PiStOn-DeEp/1st-Philippine-Can-Satellite-Rocket-Competition-2024-2025/README.md

# 1st-Philippine-Can-Satellite-Rocket-Competition-2024-2025
Contains information and files of critical design review paper of our CanSat
