PiStOn-DeEp/1st-Philippine-Can-Satellite-Rocket-Competition-2024-2025/Assembly-Half-Payload-v1-1-1.pdf

E E

F F

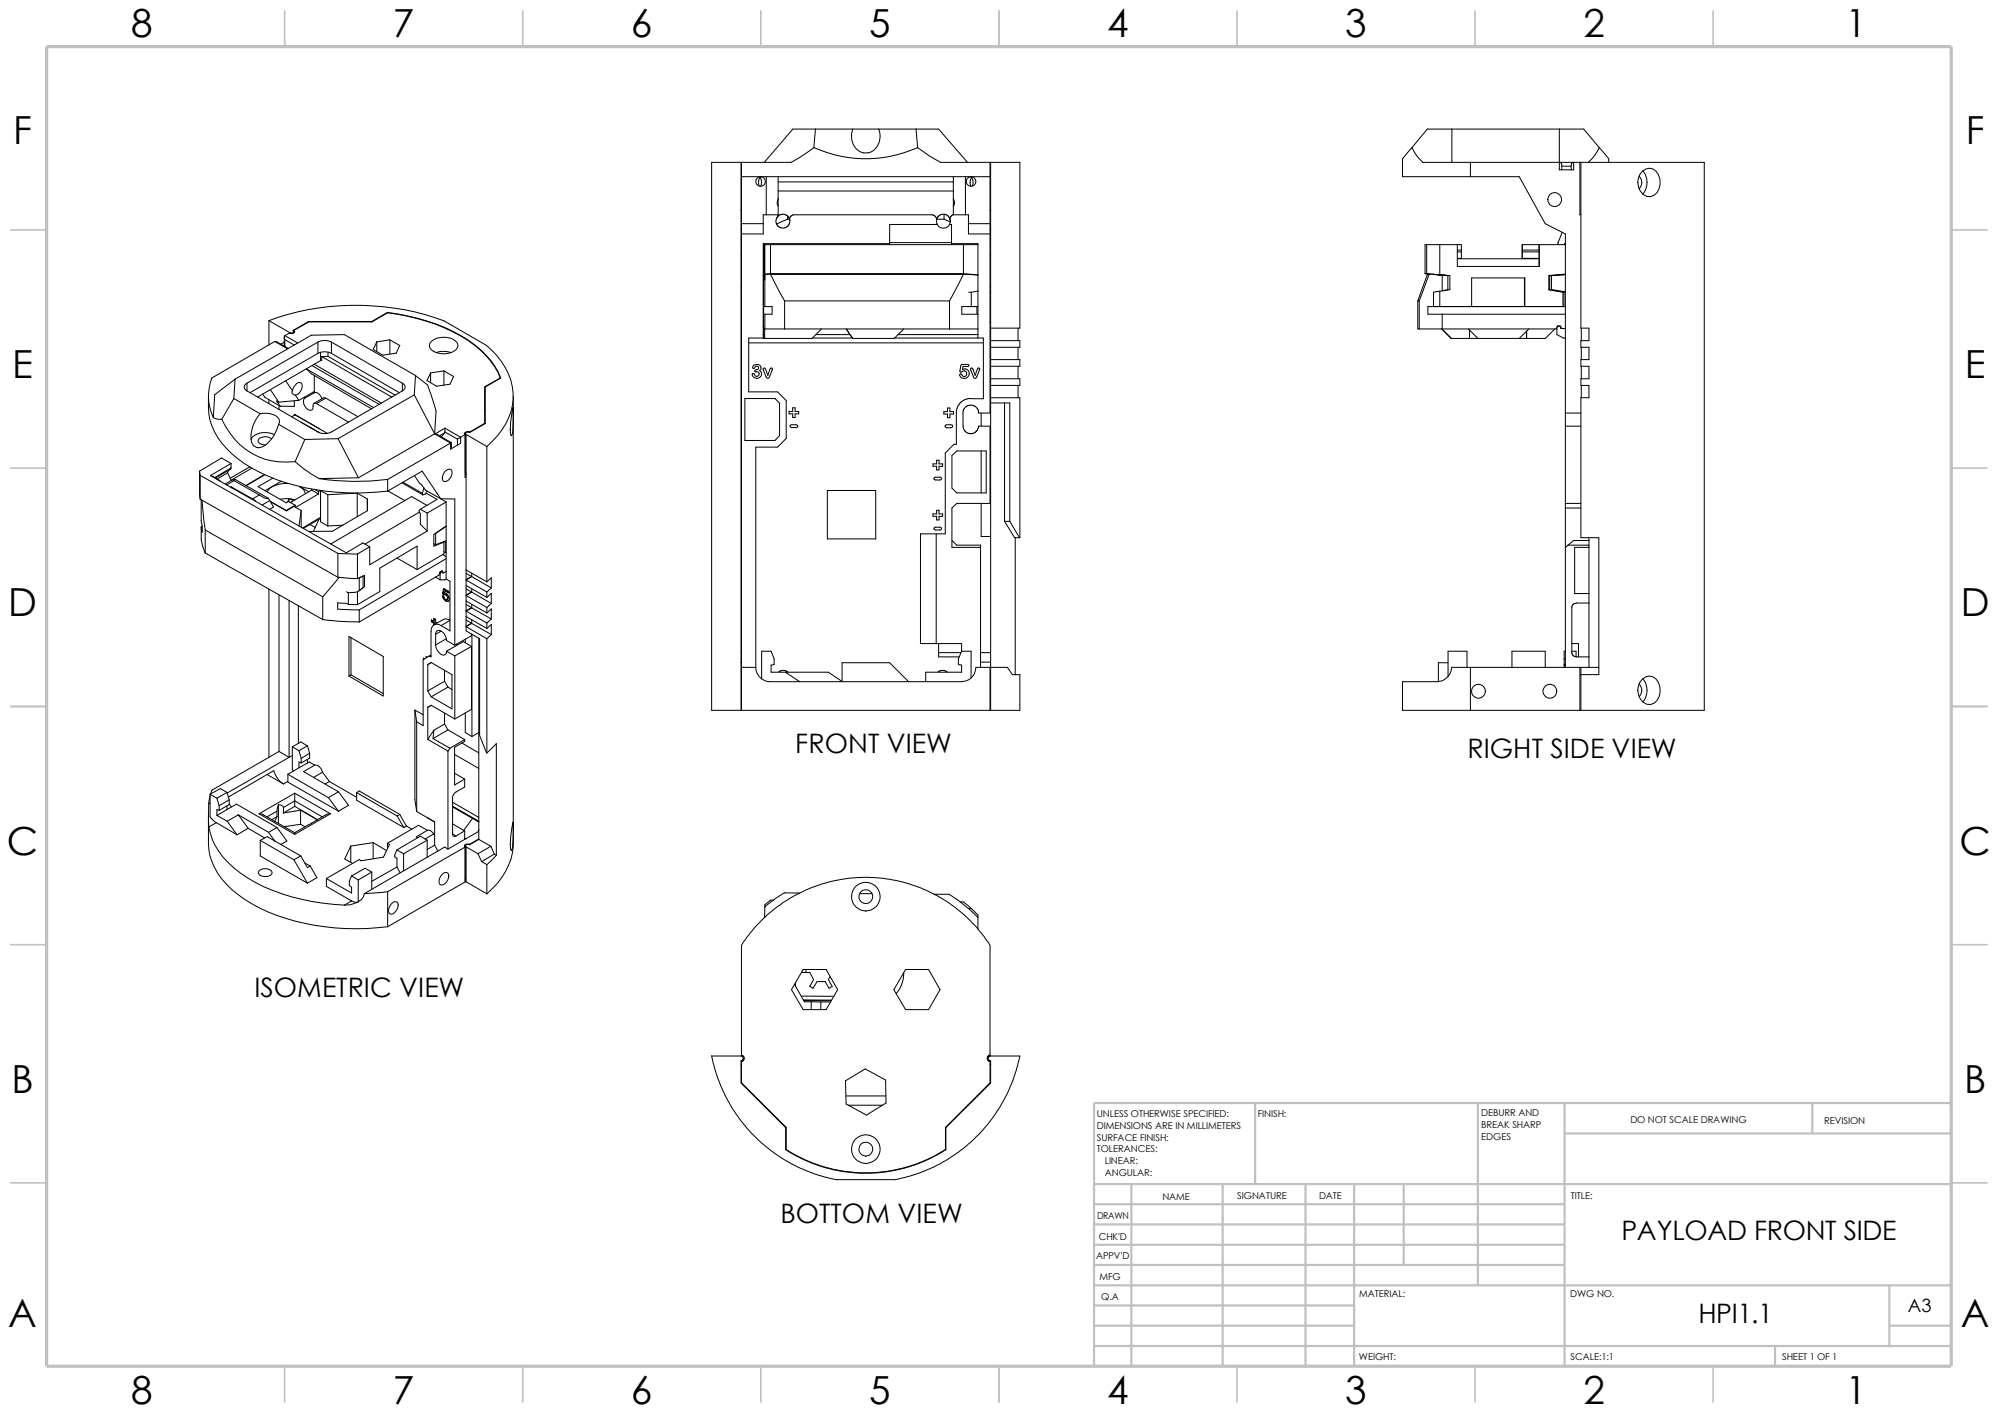
[picture p46: page 1]
SCALE:1:1; A A HPI1.1; WEIGHT:; SHEET 1 OF 1; REVISION; FINISH:; EDGES; DEBURR AND BREAK SHARP; ISOMETRIC VIEW; FRONT VIEW; BOTTOM VIEW

RIGHT SIDE VIEW

DO NOT SCALE DRAWING UNLESS OTHERWISE SPECIFIED:
DIMENSIONS ARE IN MILLIMETERS
SURFACE FINISH:
TOLERANCES:
LINEAR:
ANGULAR:

NAME | SIGNATURE | DATE | | | | TITLE: PAYLOAD FRONT SIDE

DRAWN
CHK'D
APPV'D
Q.A | | | | MATERIAL: | DWG NO. | A3

MFG
