PiStOn-DeEp/1st-Philippine-Can-Satellite-Rocket-Competition-2024-2025/Specimen-Payload-Case-v1-1.pdf

E E

F F

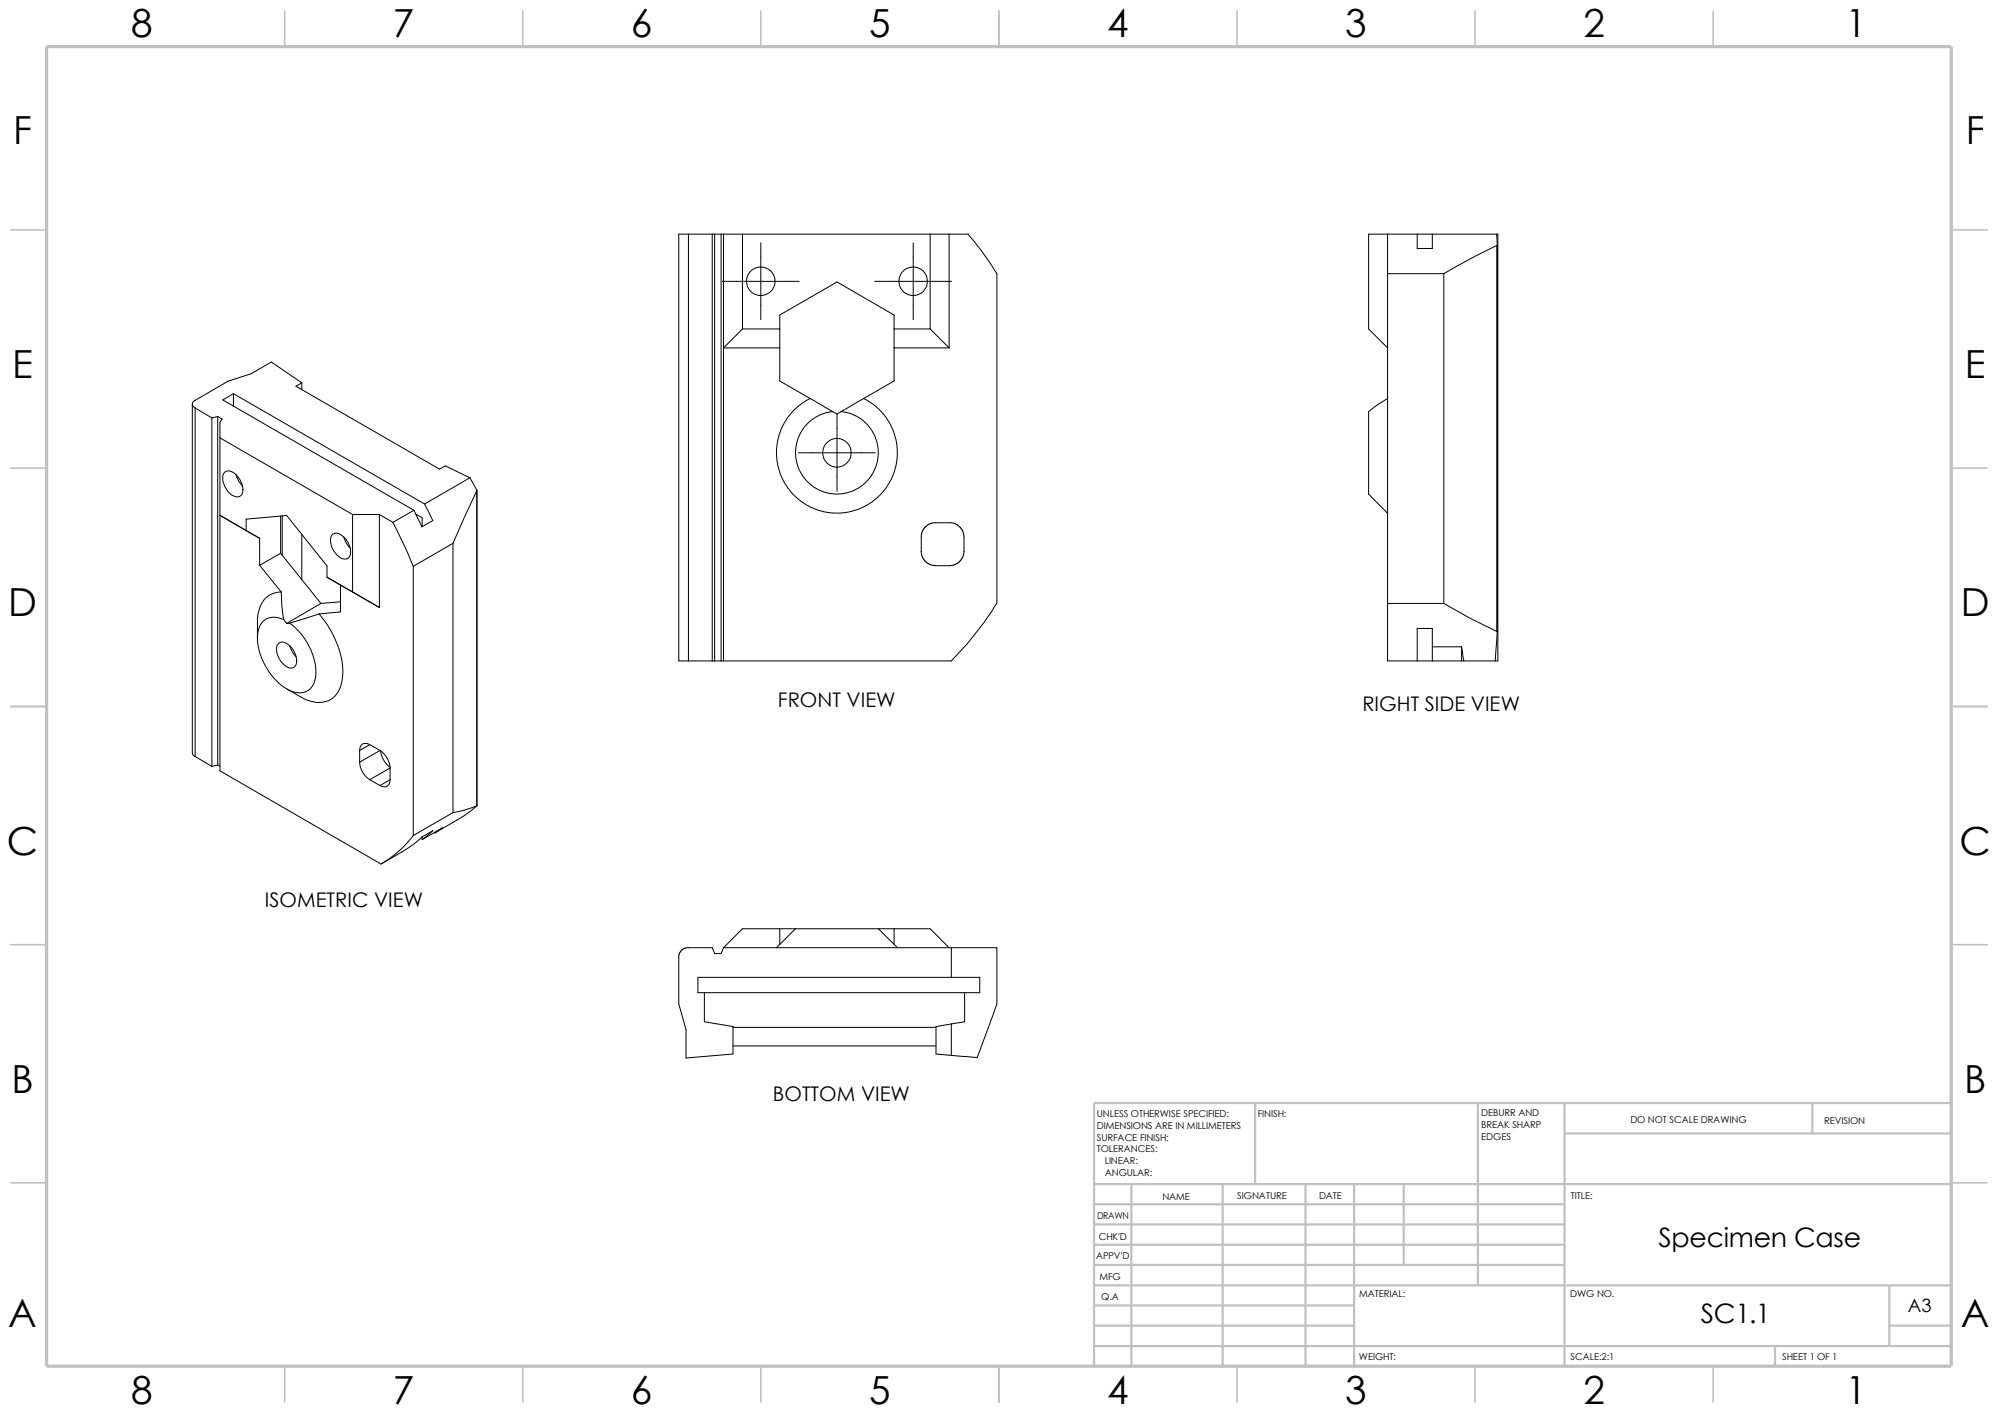
[picture p47: page 1]
SHEET 1 OF 1; WEIGHT:; REVISION; SCALE:2:1; FINISH:; EDGES; DEBURR AND BREAK SHARP; BOTTOM VIEW; ISOMETRIC VIEW; FRONT VIEW; RIGHT SIDE VIEW

UNLESS OTHERWISE SPECIFIED:
DIMENSIONS ARE IN MILLIMETERS
SURFACE FINISH:
TOLERANCES:
LINEAR:
ANGULAR:

DO NOT SCALE DRAWING

NAME | SIGNATURE | DATE | | | | TITLE: Specimen Case

DRAWN
CHK'D
APPV'D
Q.A | | | | MATERIAL: | DWG NO. | A3

MFG
