PiStOn-DeEp/1st-Philippine-Can-Satellite-Rocket-Competition-2024-2025/Specimen-Payload-Case-v1-2.pdf

E E

F F

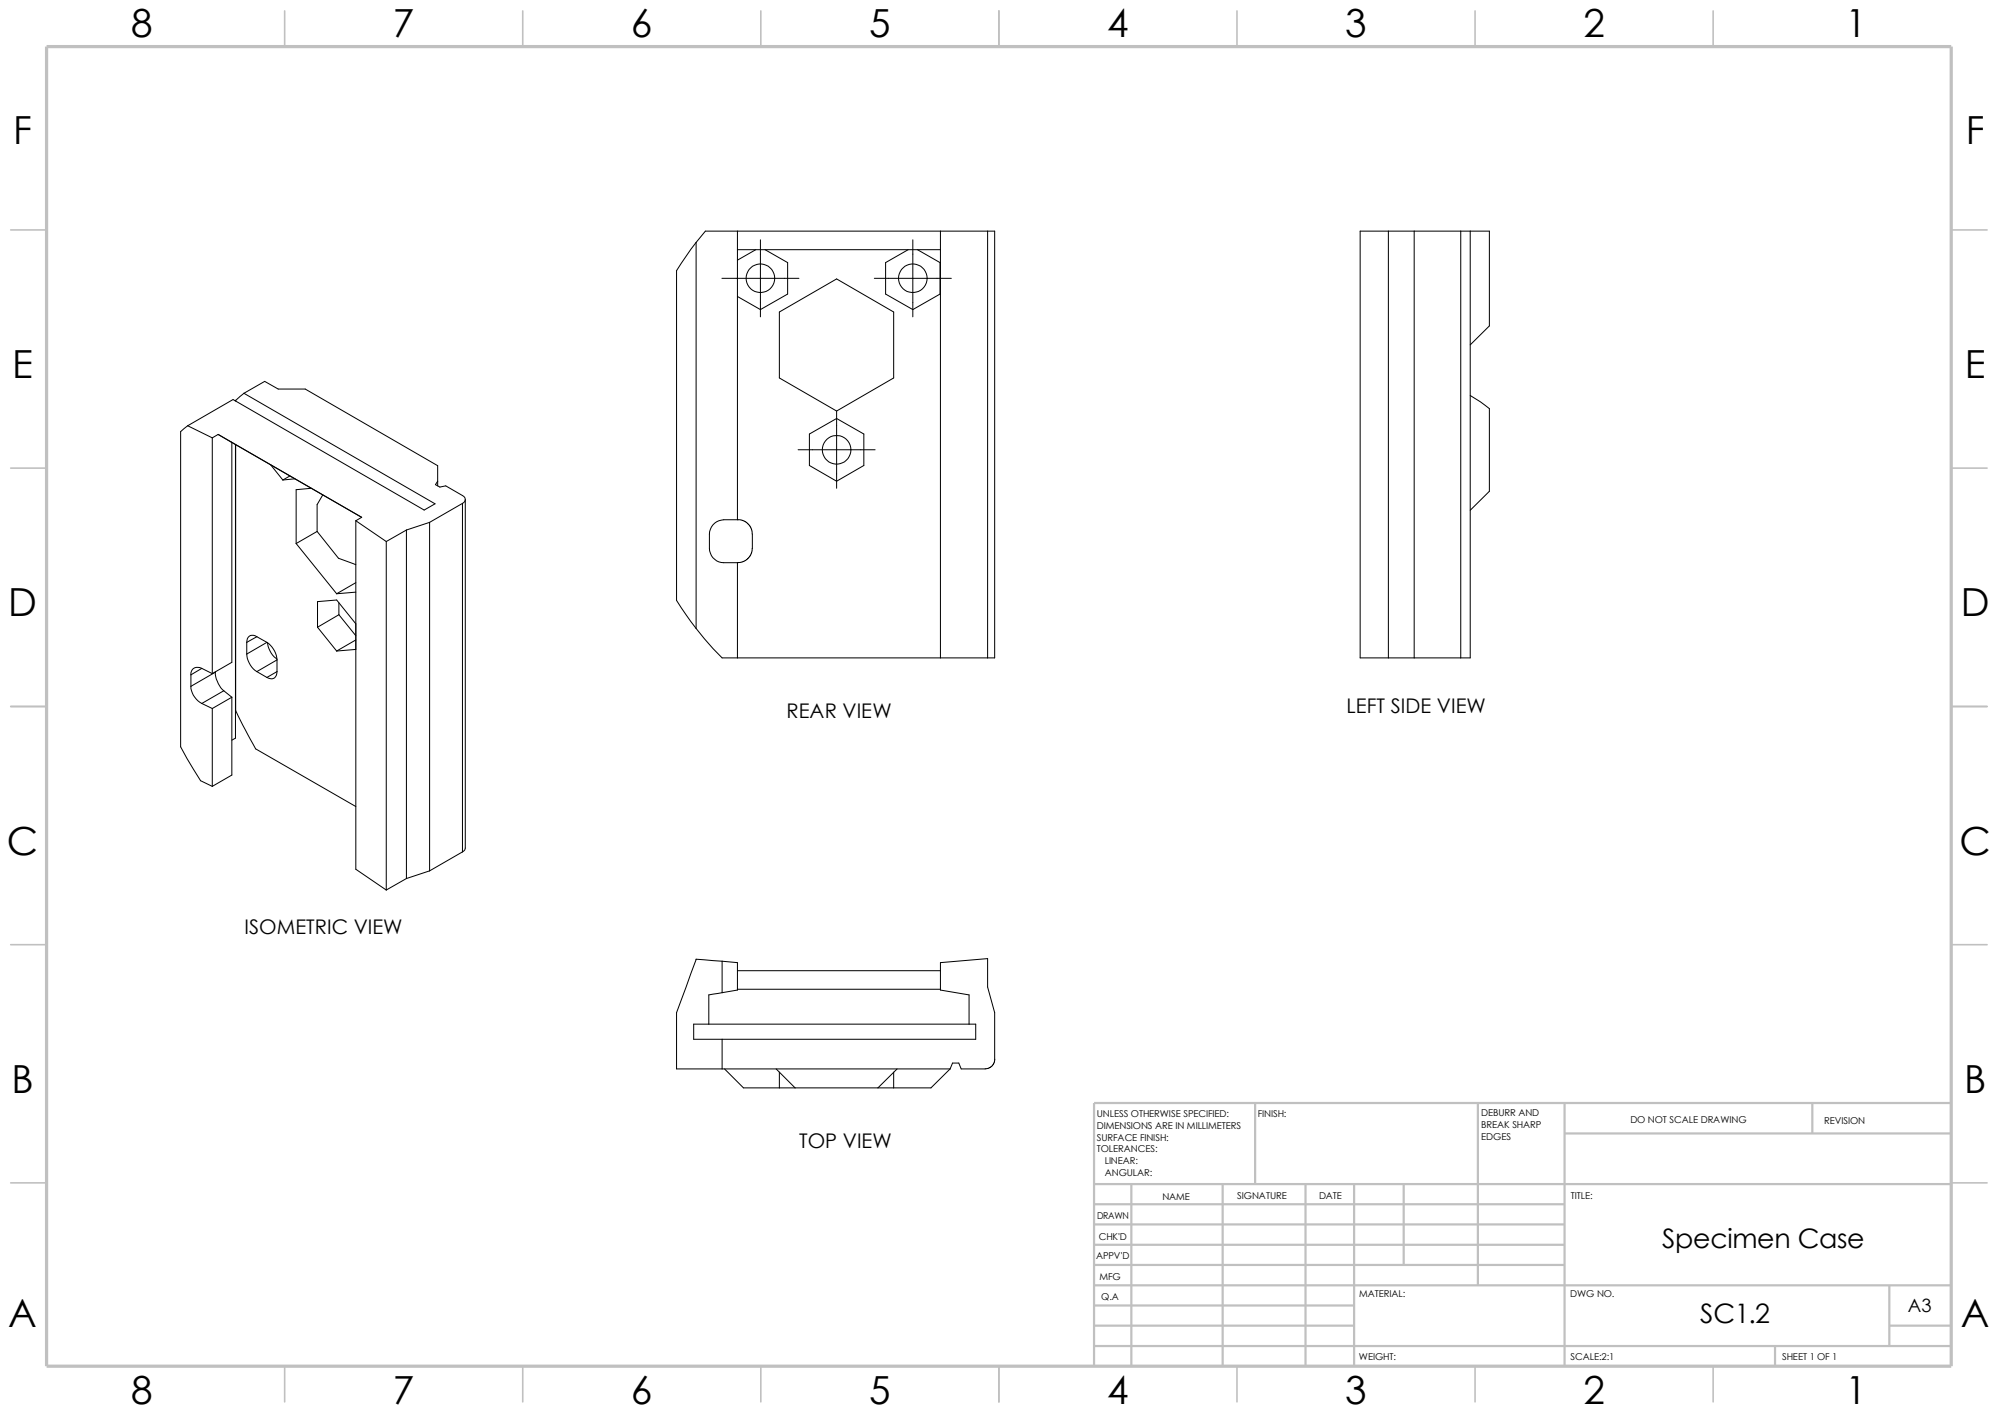
[picture p48: page 1]
SHEET 1 OF 1; WEIGHT:; SCALE:2:1; REVISION; FINISH:; EDGES; DEBURR AND BREAK SHARP; REAR VIEW; LEFT SIDE VIEW; ISOMETRIC VIEW; TOP VIEW

DO NOT SCALE DRAWING UNLESS OTHERWISE SPECIFIED:
DIMENSIONS ARE IN MILLIMETERS
SURFACE FINISH:
TOLERANCES:
LINEAR:
ANGULAR:

NAME | SIGNATURE | DATE | | | | TITLE: Specimen Case

DRAWN
CHK'D
APPV'D
Q.A | | | | MATERIAL: | DWG NO. | A3

MFG
