PiStOn-DeEp/1st-Philippine-Can-Satellite-Rocket-Competition-2024-2025/Whole-Assembly-v2-1-1.pdf

E E

F F

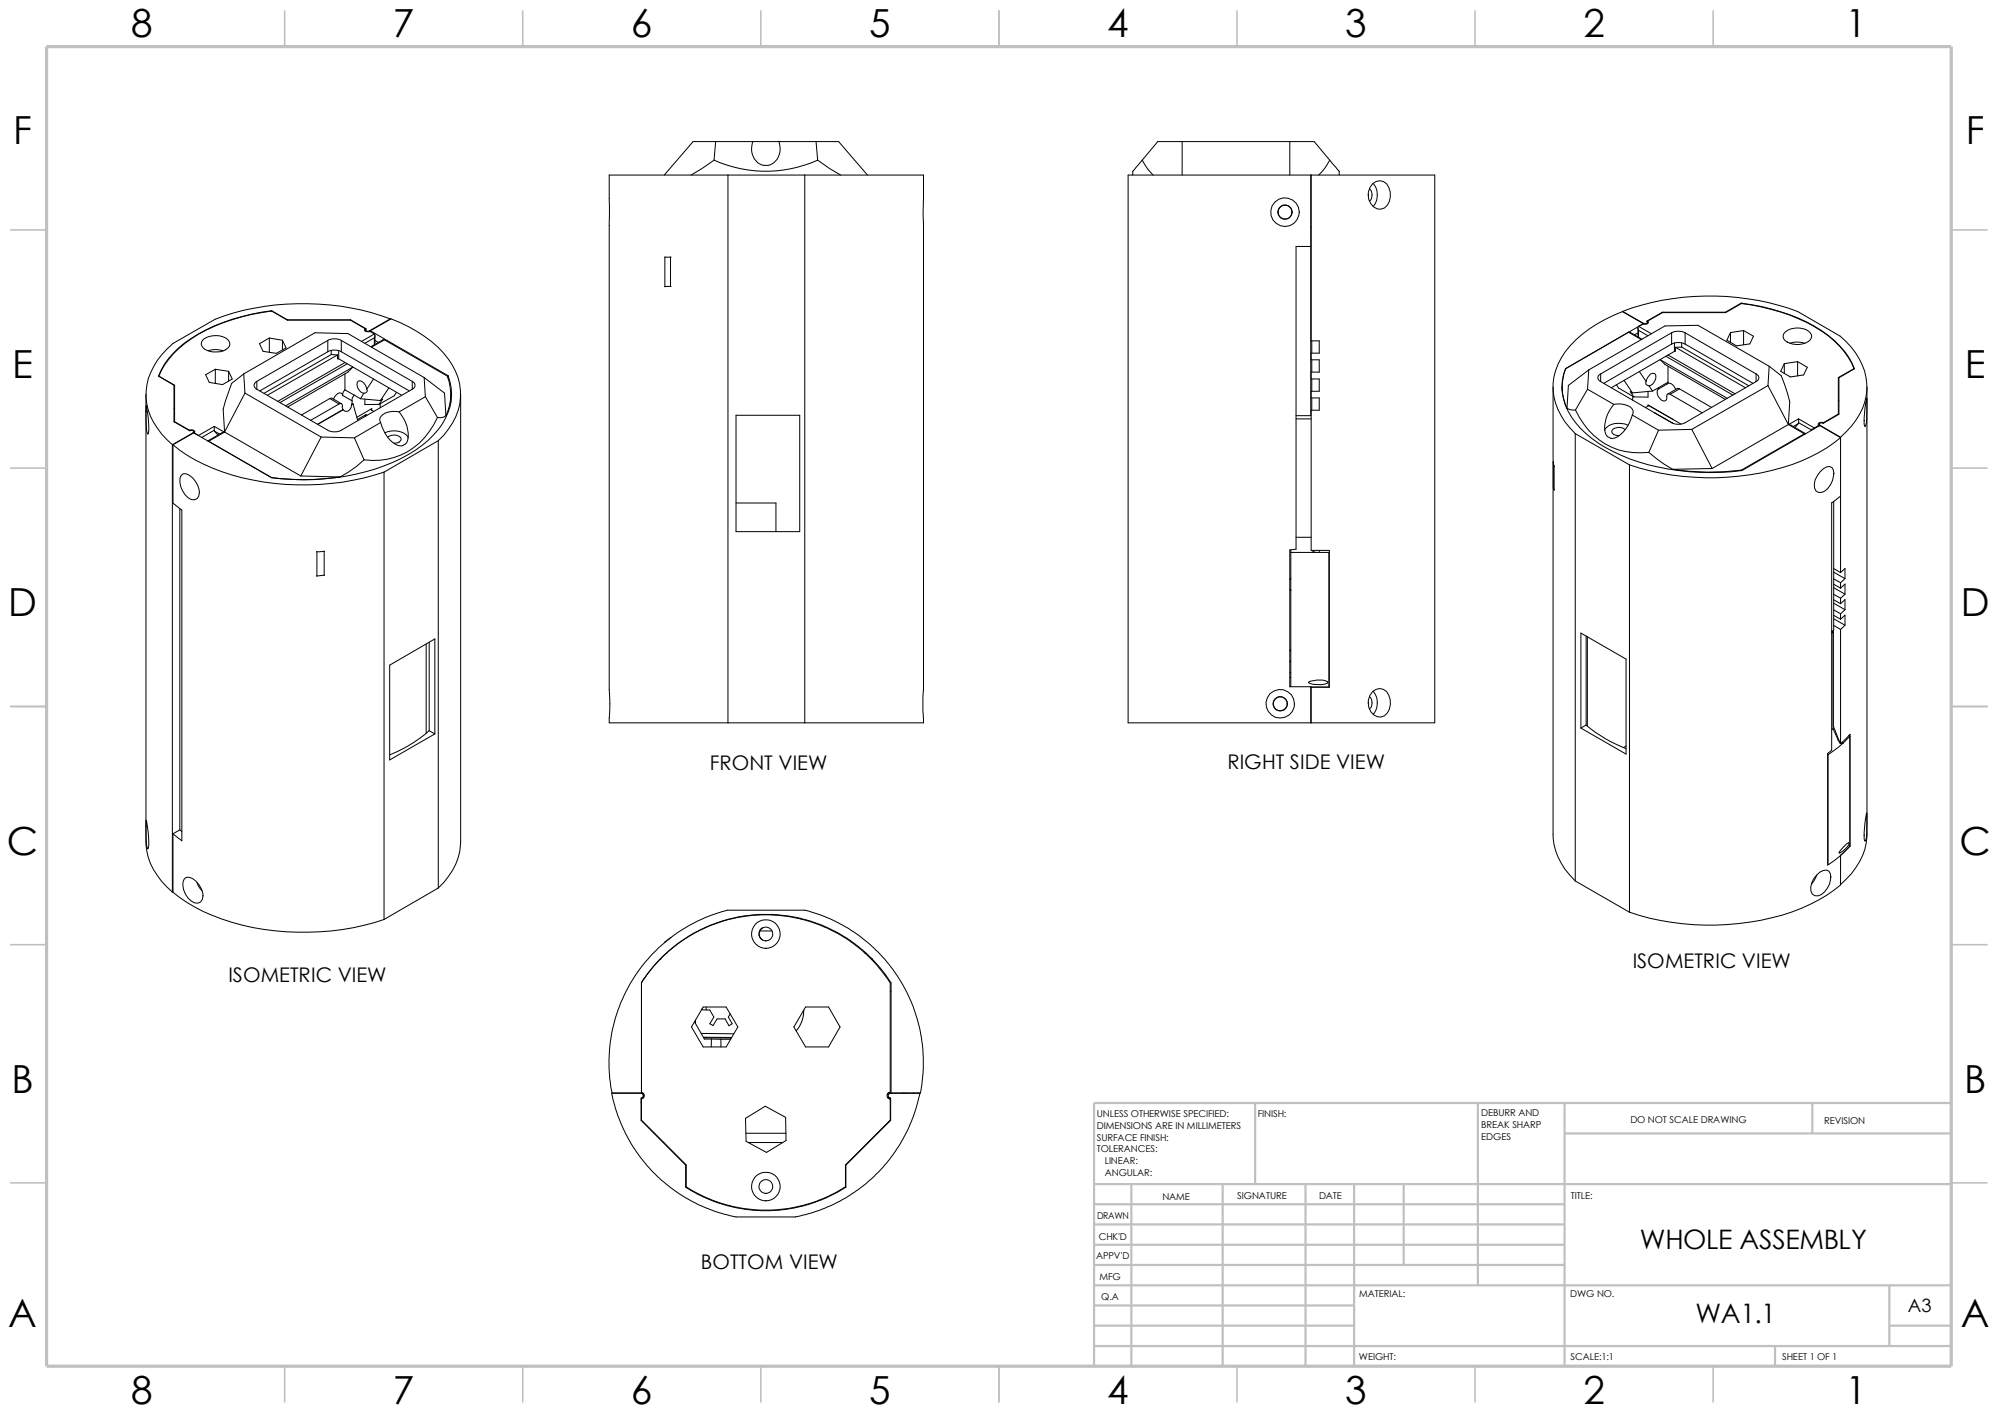
[picture p49: page 1]
WEIGHT:; SHEET 1 OF 1; SCALE:1:1; FINISH:; EDGES; DO NOT SCALE DRAWING; REVISION; DEBURR AND BREAK SHARP; BOTTOM VIEW; FRONT VIEW; RIGHT SIDE VIEW; ISOMETRIC VIEW

UNLESS OTHERWISE SPECIFIED:
DIMENSIONS ARE IN MILLIMETERS
SURFACE FINISH:
TOLERANCES:
LINEAR:
ANGULAR:

NAME | SIGNATURE | DATE | | | | TITLE: WHOLE ASSEMBLY

DRAWN
CHK'D
APPV'D

MFG
Q.A | | | | MATERIAL: | DWG NO. | A3
