PiStOn-DeEp/1st-Philippine-Can-Satellite-Rocket-Competition-2024-2025/Whole-Assembly-v2-1-2.pdf

E E

F F

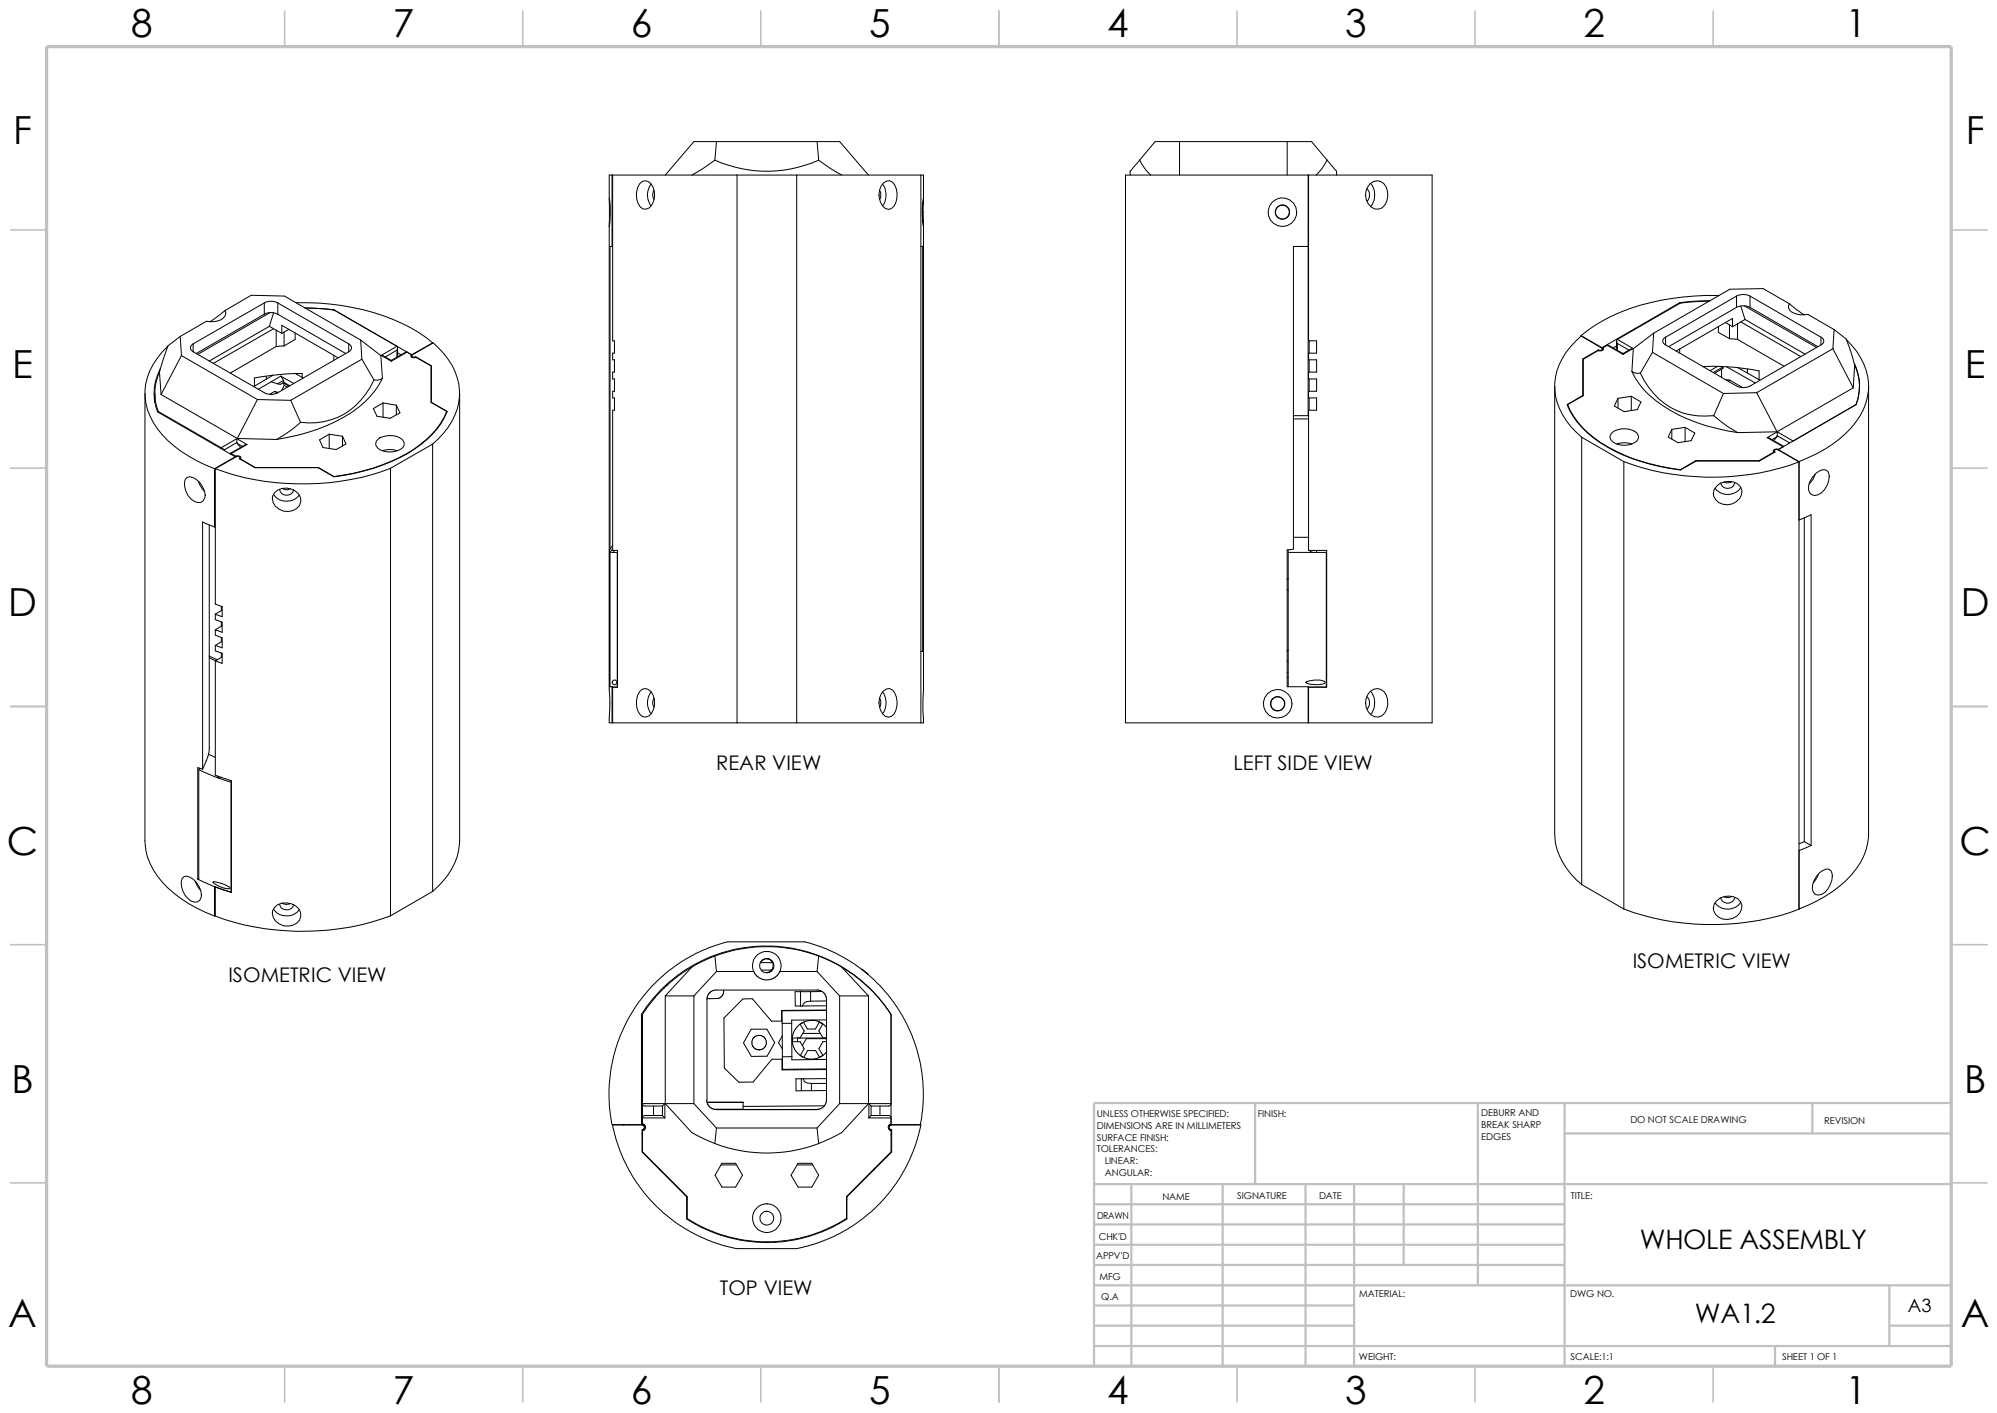
[picture p50: page 1]
WEIGHT:; SHEET 1 OF 1; SCALE:1:1; REVISION; FINISH:; EDGES; DEBURR AND BREAK SHARP; REAR VIEW; LEFT SIDE VIEW; TOP VIEW; ISOMETRIC VIEW

DO NOT SCALE DRAWING UNLESS OTHERWISE SPECIFIED:
DIMENSIONS ARE IN MILLIMETERS
SURFACE FINISH:
TOLERANCES:
LINEAR:
ANGULAR:

NAME | SIGNATURE | DATE | | | | TITLE: WHOLE ASSEMBLY

DRAWN
CHK'D
APPV'D
Q.A | | | | MATERIAL: | DWG NO. | A3

MFG
