PiStOn-DeEp/1st-Philippine-Can-Satellite-Rocket-Competition-2024-2025/Battery-Frame-v1-1.pdf

E E

F F

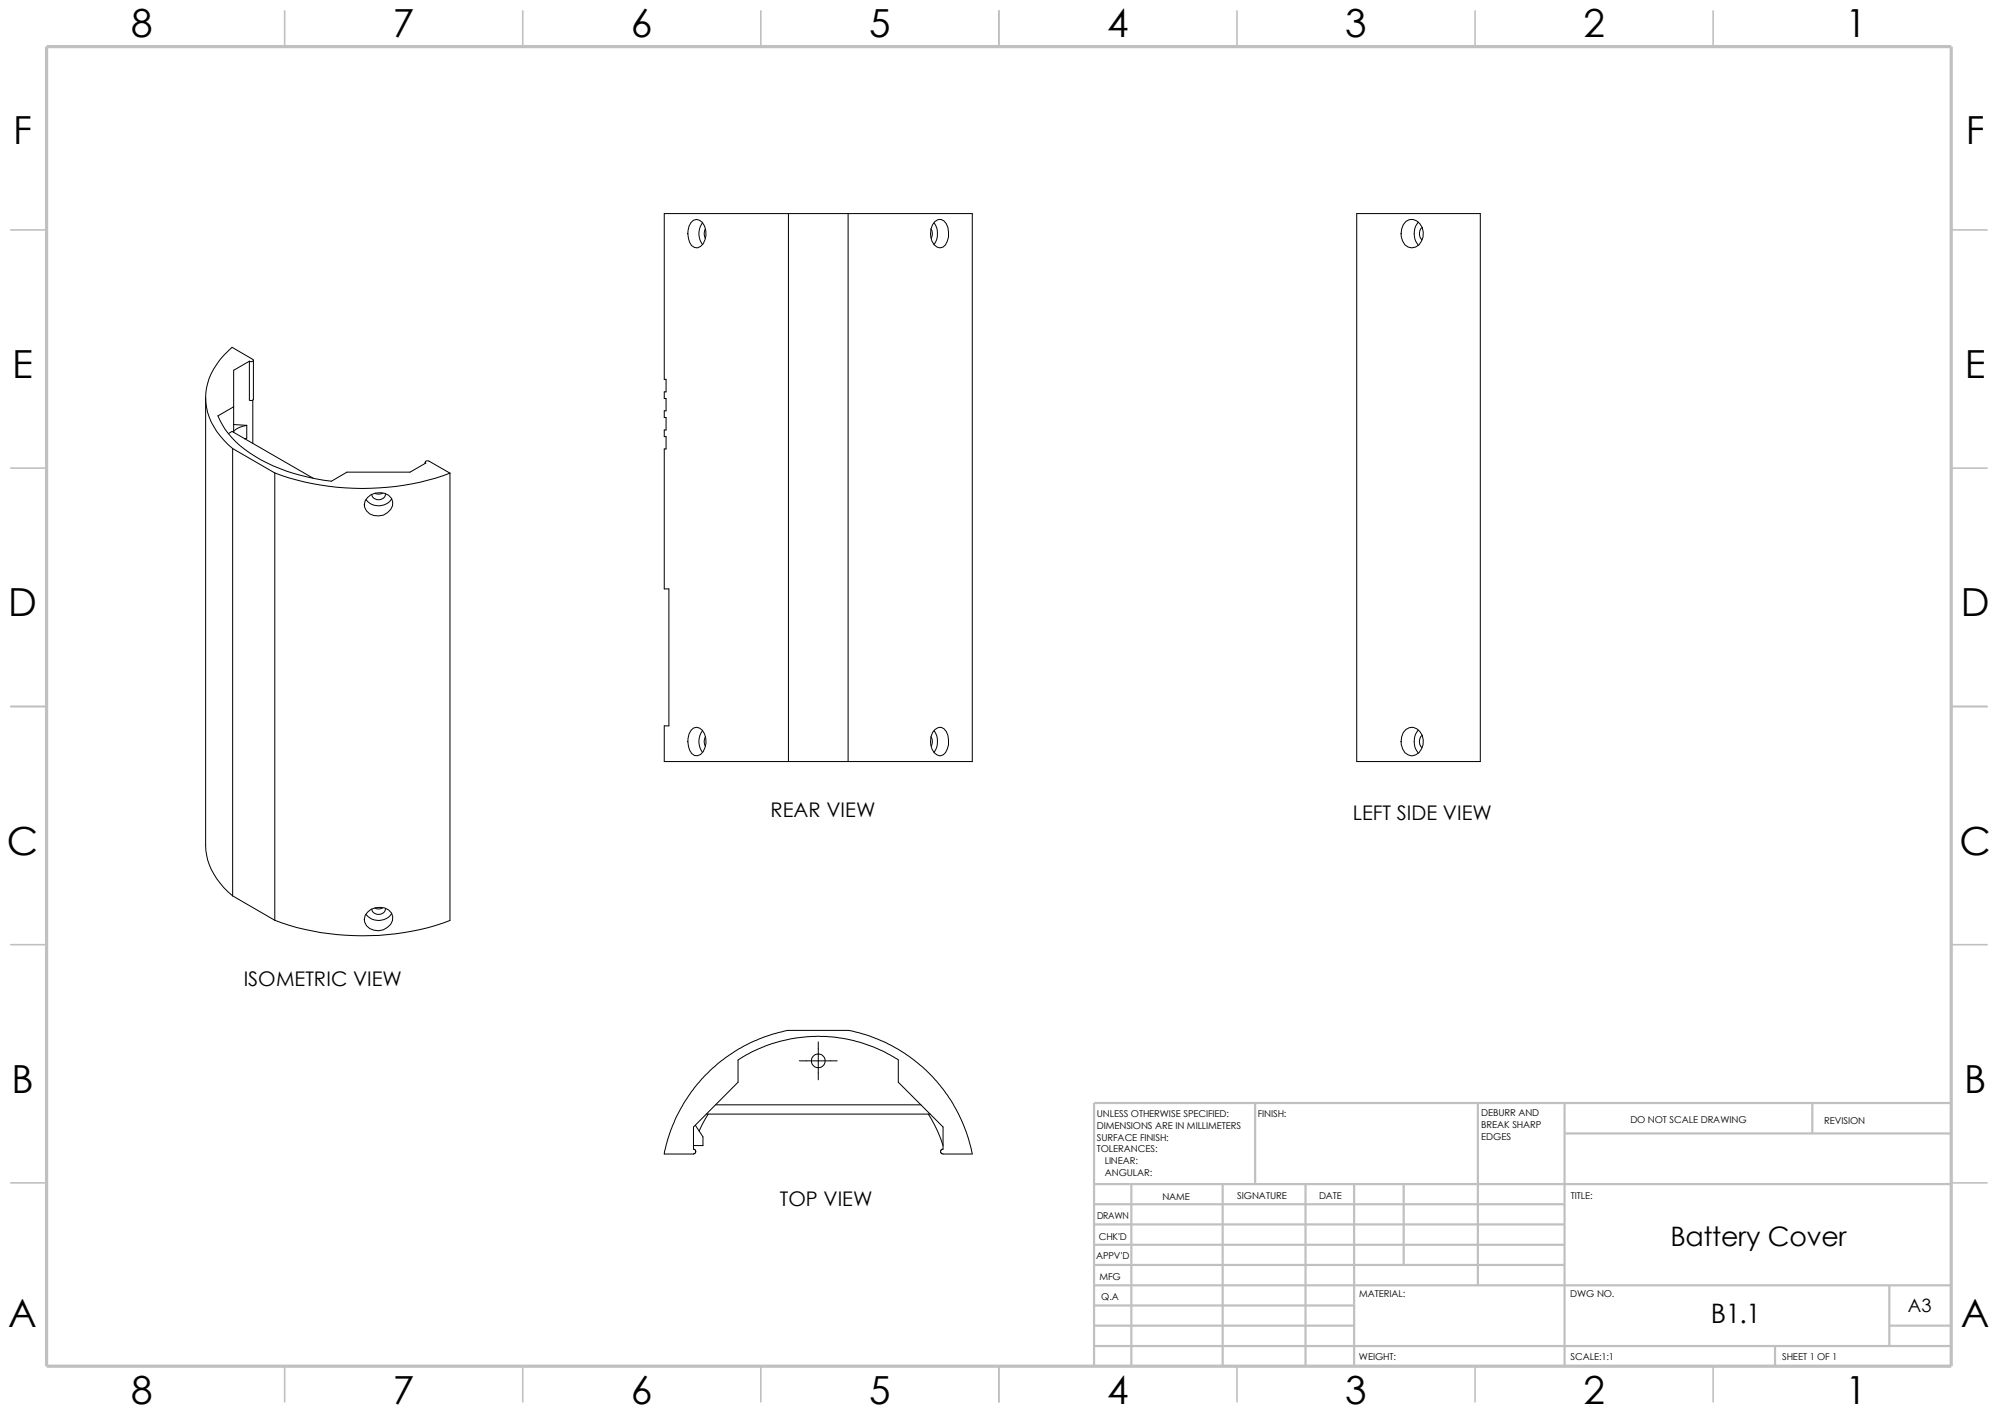
[picture p51: page 1]
SHEET 1 OF 1; WEIGHT:; REVISION; SCALE:1:1; FINISH:; EDGES; DEBURR AND BREAK SHARP; ISOMETRIC VIEW; TOP VIEW; REAR VIEW; LEFT SIDE VIEW

UNLESS OTHERWISE SPECIFIED:
DIMENSIONS ARE IN MILLIMETERS
SURFACE FINISH:
TOLERANCES:
LINEAR:
ANGULAR:

DO NOT SCALE DRAWING

NAME | SIGNATURE | DATE | | | | TITLE: Battery Cover

DRAWN
CHK'D
APPV'D
Q.A | | | | MATERIAL: | DWG NO. | A3

MFG
