PiStOn-DeEp/1st-Philippine-Can-Satellite-Rocket-Competition-2024-2025/Battery-Frame-v1-2.pdf

E E

F F

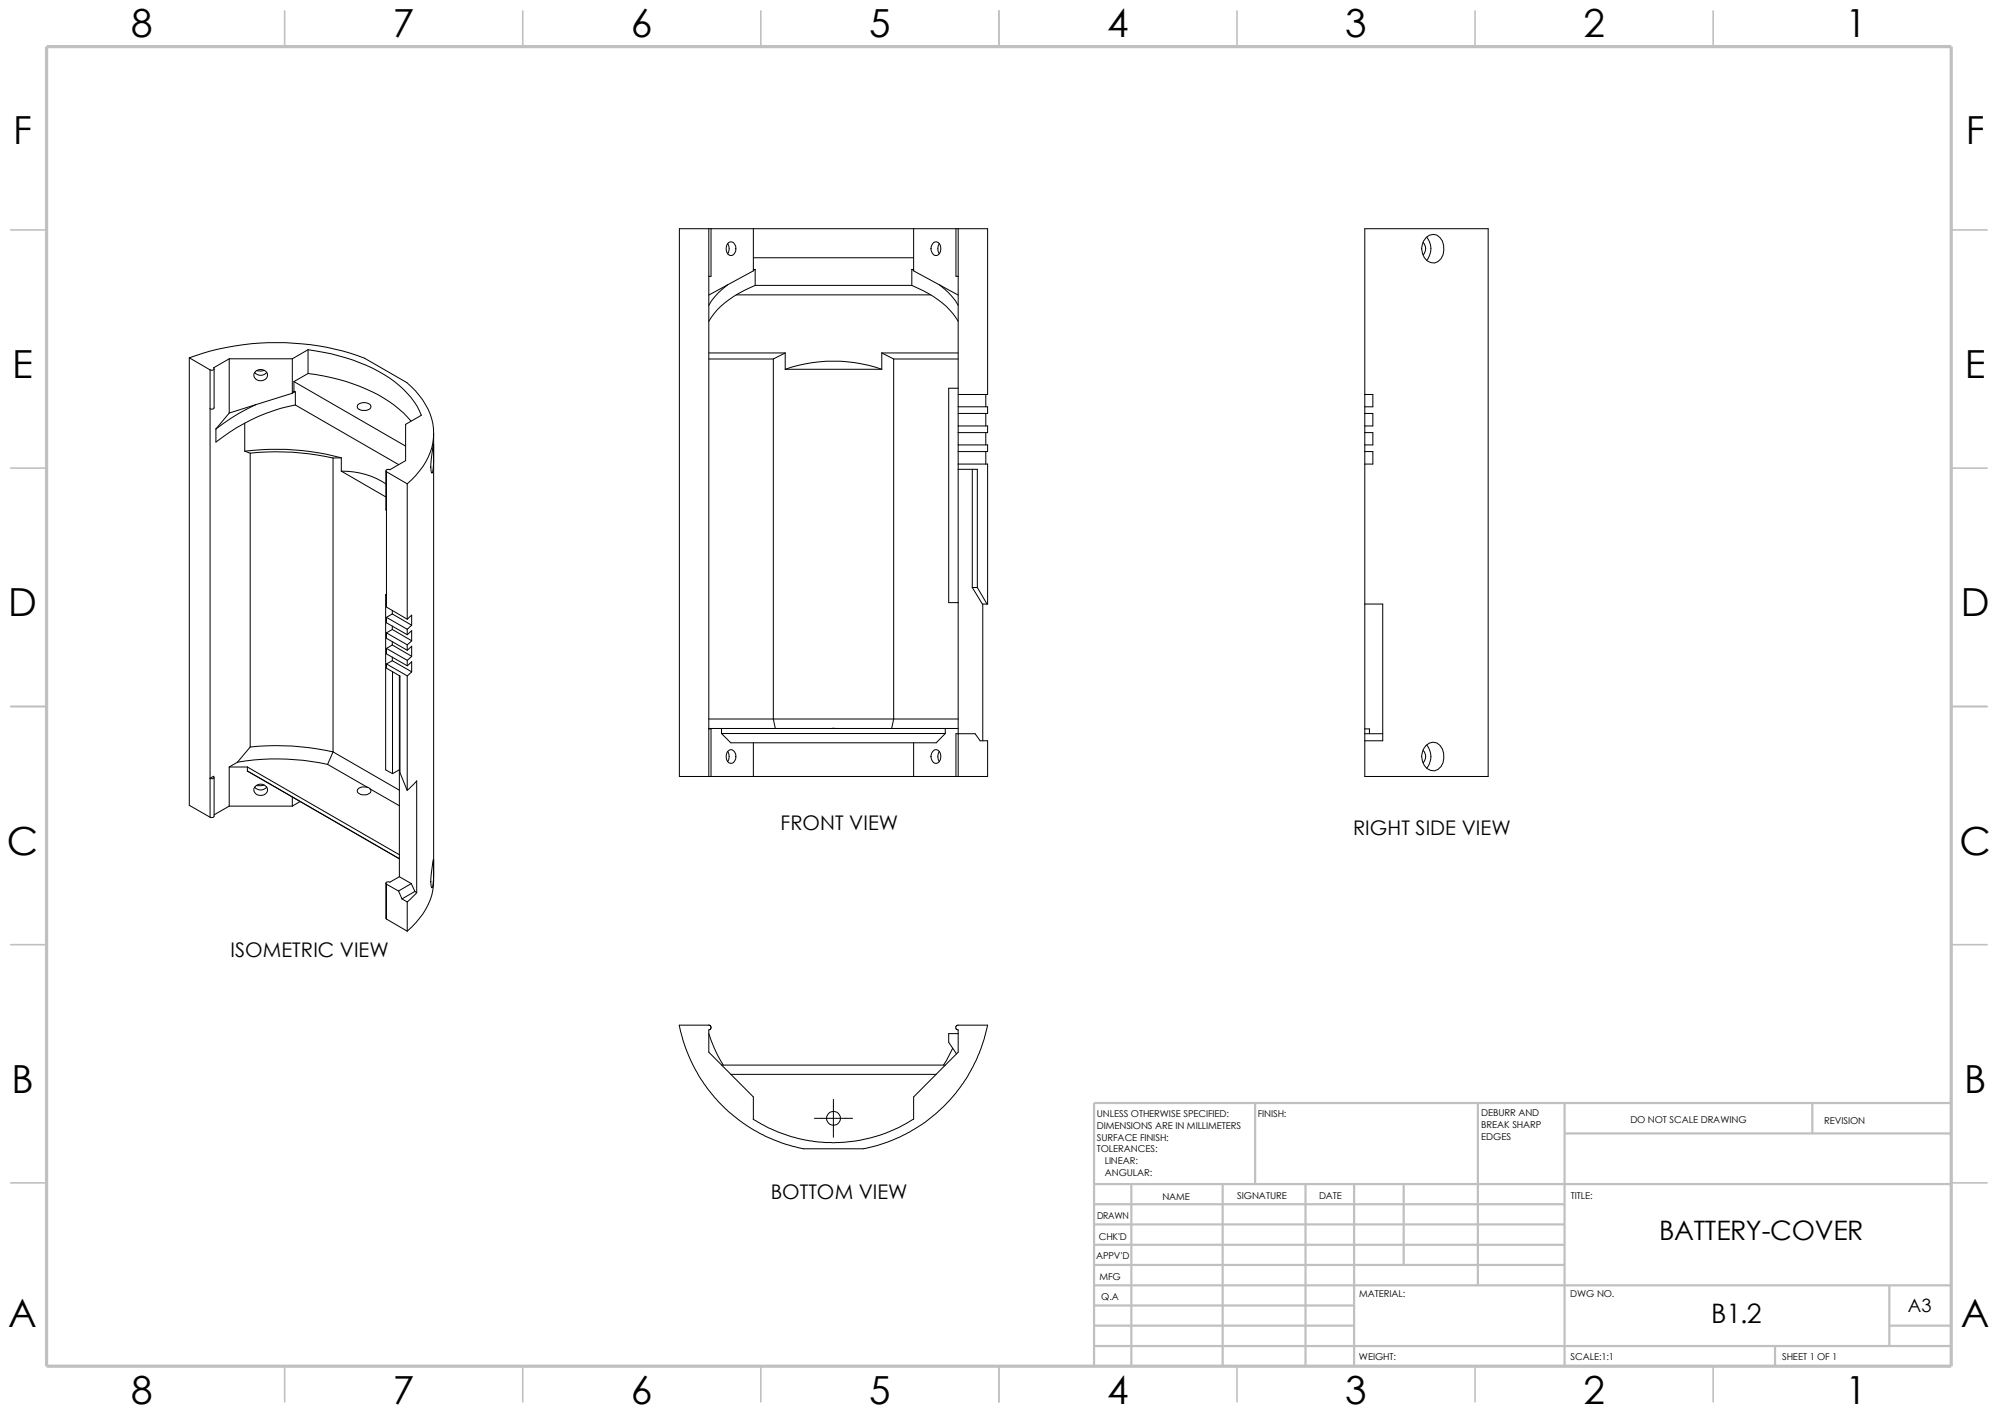
[picture p52: page 1]
SHEET 1 OF 1; SCALE:1:1; WEIGHT:; FINISH:; EDGES; DO NOT SCALE DRAWING; REVISION; DEBURR AND BREAK SHARP; FRONT VIEW; RIGHT SIDE VIEW; BOTTOM VIEW; ISOMETRIC VIEW

UNLESS OTHERWISE SPECIFIED:
DIMENSIONS ARE IN MILLIMETERS
SURFACE FINISH:
TOLERANCES:
LINEAR:
ANGULAR:

NAME | SIGNATURE | DATE | | | | TITLE: BATTERY-COVER

DRAWN
CHK'D
APPV'D
Q.A | | | | MATERIAL: | DWG NO. | A3

MFG
