PiStOn-DeEp/1st-Philippine-Can-Satellite-Rocket-Competition-2024-2025/Camera-Box-Payload-Case-v1-1.pdf

E E

F F

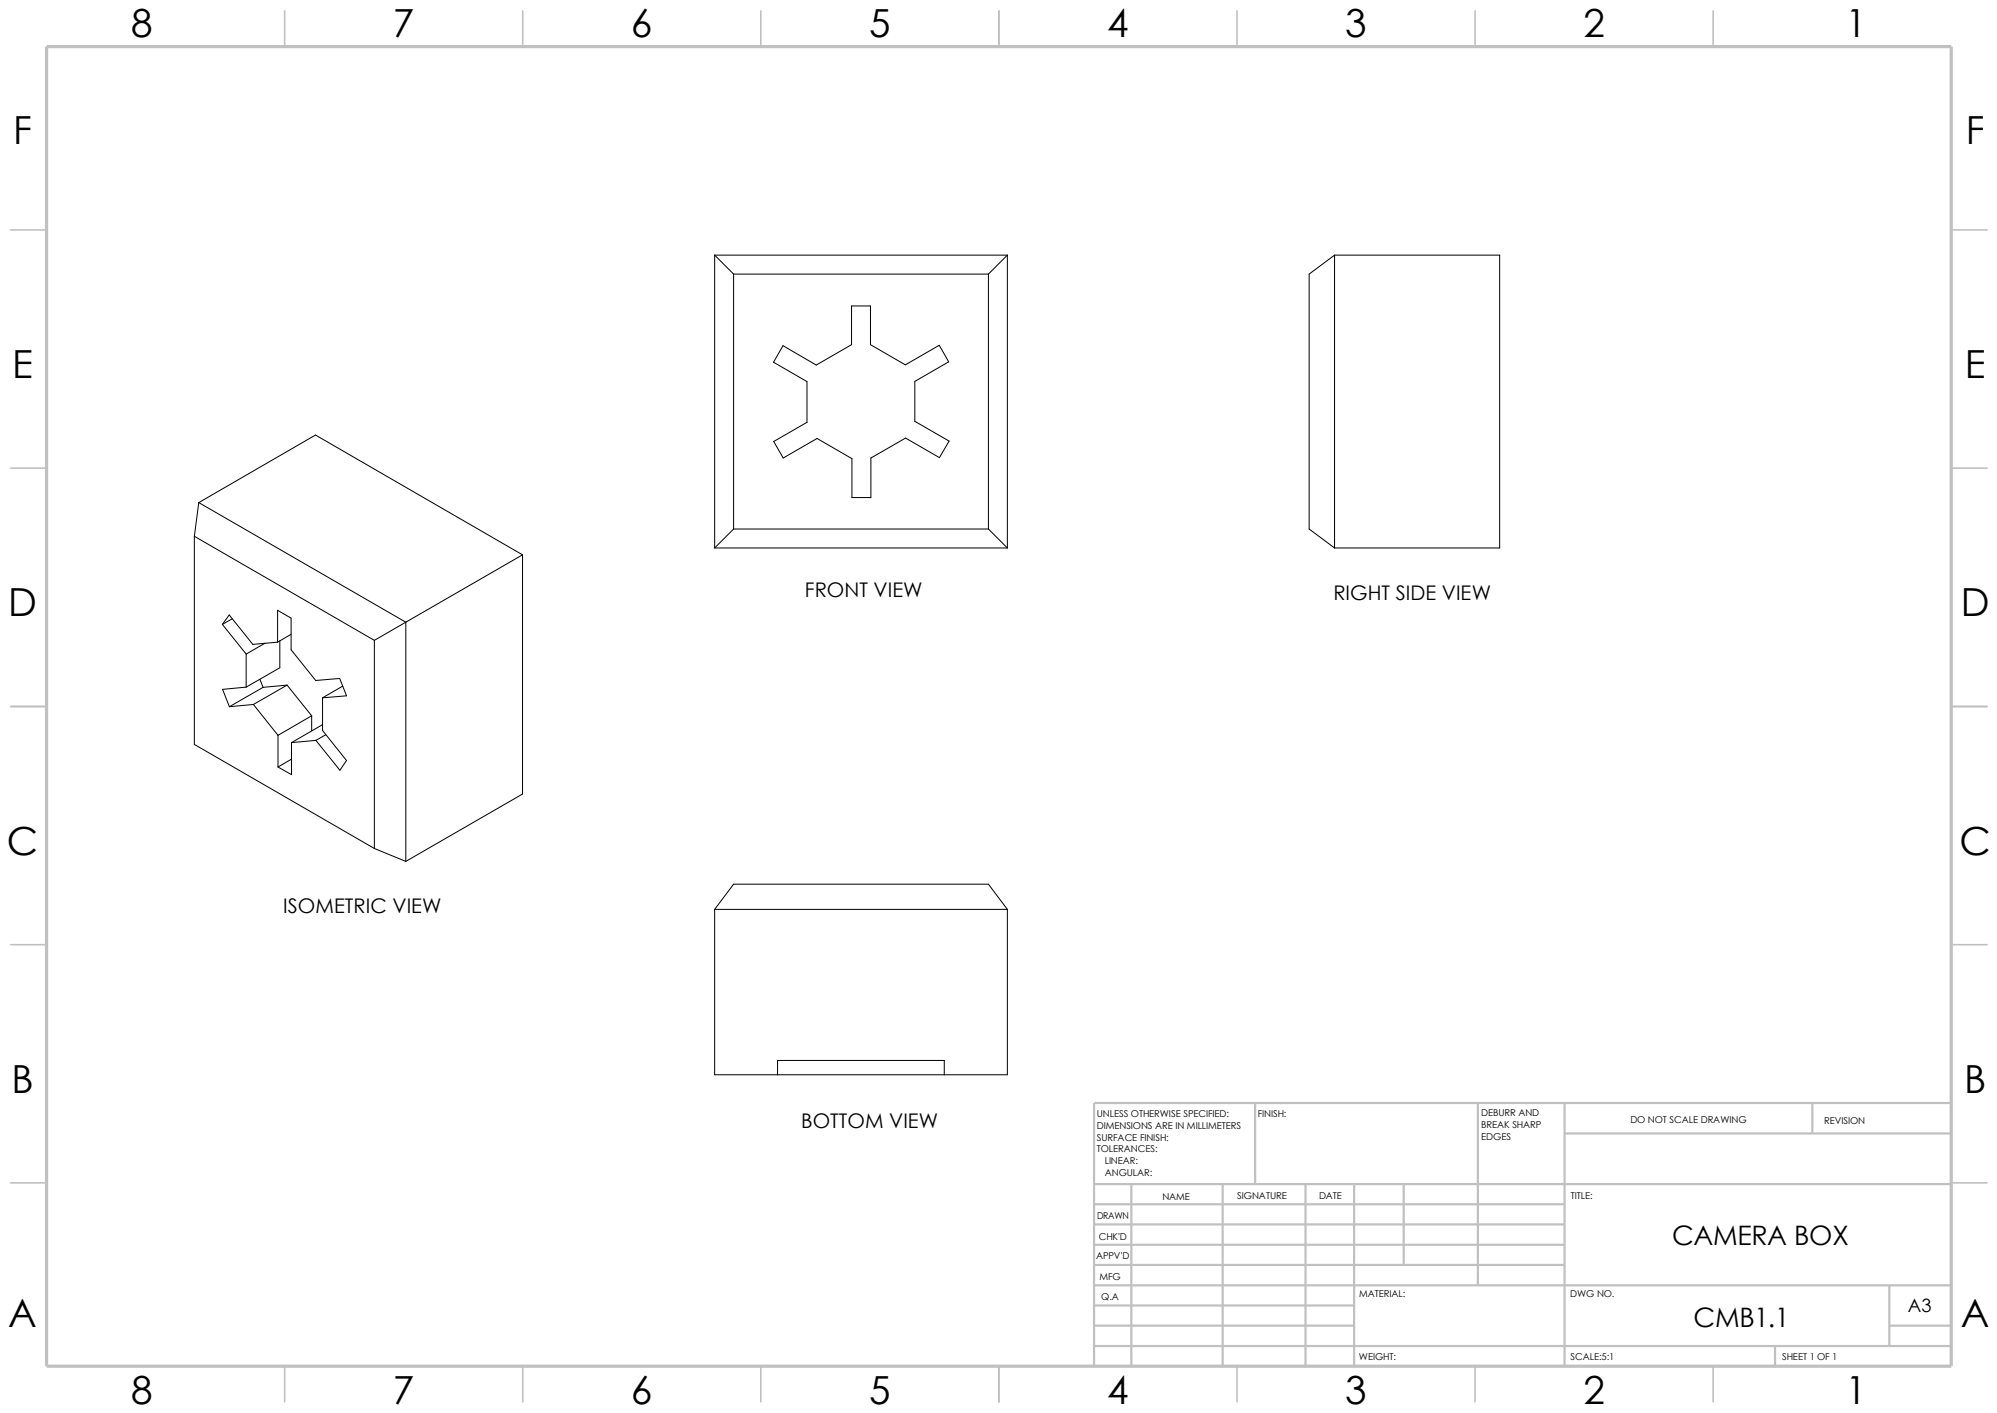
[picture p53: page 1]
SCALE:5:1; A A CMB1.1; WEIGHT:; SHEET 1 OF 1; FINISH:; EDGES; DO NOT SCALE DRAWING; REVISION; DEBURR AND BREAK SHARP; FRONT VIEW; BOTTOM VIEW; ISOMETRIC VIEW

RIGHT SIDE VIEW

UNLESS OTHERWISE SPECIFIED:
DIMENSIONS ARE IN MILLIMETERS
SURFACE FINISH:
TOLERANCES:
LINEAR:
ANGULAR:

NAME | SIGNATURE | DATE | | | | TITLE: CAMERA BOX

DRAWN
CHK'D
APPV'D
Q.A | | | | MATERIAL: | DWG NO. | A3

MFG
