PiStOn-DeEp/1st-Philippine-Can-Satellite-Rocket-Competition-2024-2025/Camera-Box-Payload-Case-v1-2.pdf

E E

F F

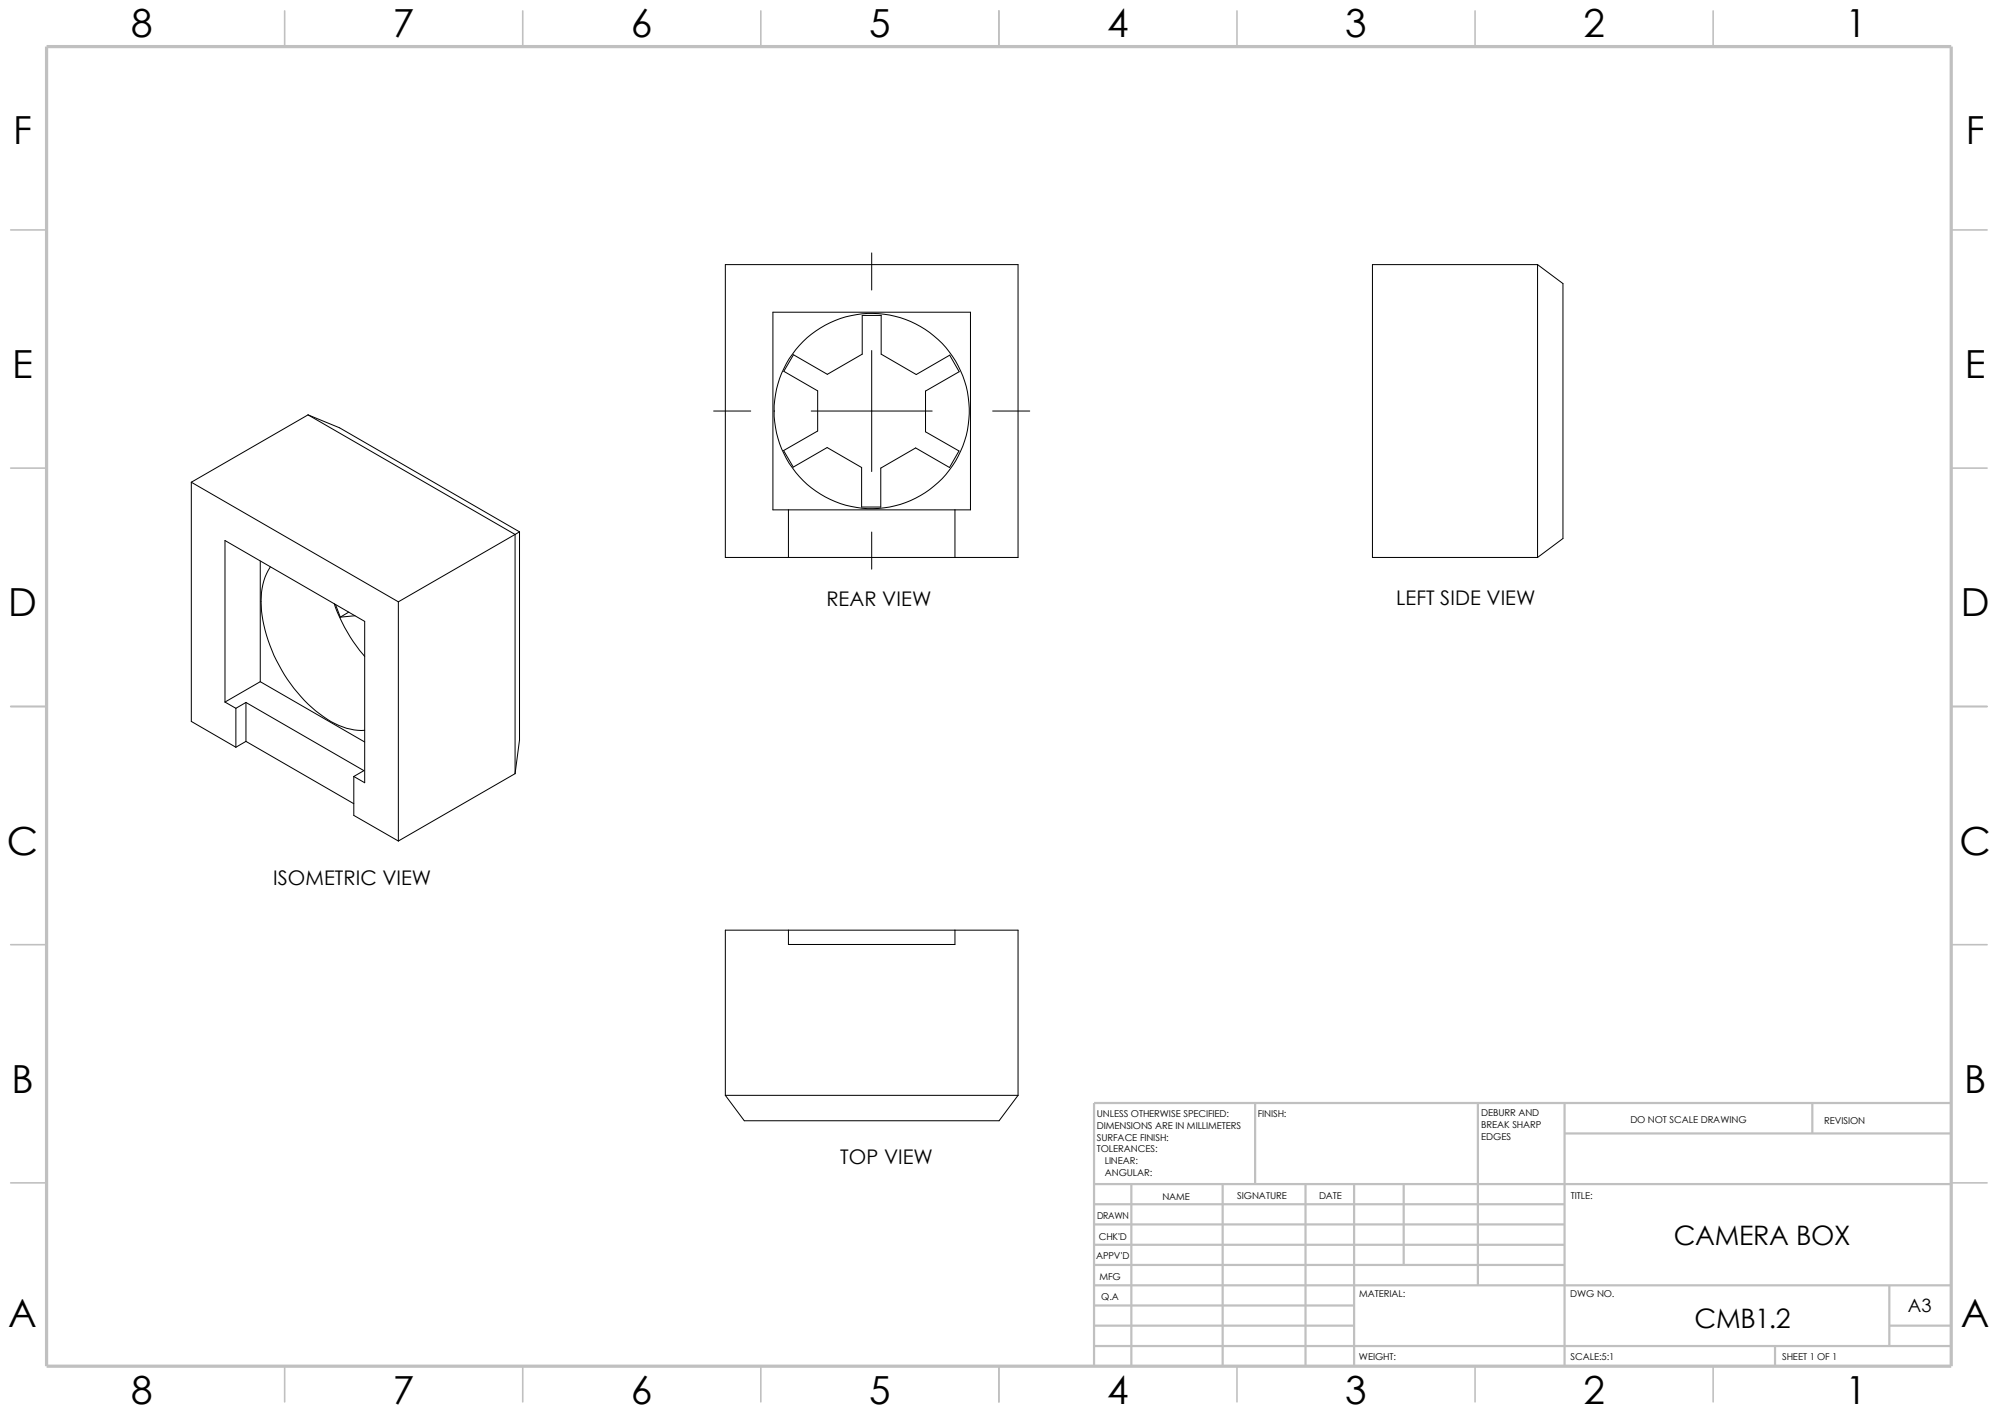
[picture p54: page 1]
SHEET 1 OF 1; A A CMB1.2; SCALE:5:1; WEIGHT:; FINISH:; EDGES; DO NOT SCALE DRAWING; REVISION; DEBURR AND BREAK SHARP; TOP VIEW; ISOMETRIC VIEW; REAR VIEW; LEFT SIDE VIEW

UNLESS OTHERWISE SPECIFIED:
DIMENSIONS ARE IN MILLIMETERS
SURFACE FINISH:
TOLERANCES:
LINEAR:
ANGULAR:

NAME | SIGNATURE | DATE | | | | TITLE: CAMERA BOX

DRAWN
CHK'D
APPV'D
Q.A | | | | MATERIAL: | DWG NO. | A3

MFG
