PiStOn-DeEp/1st-Philippine-Can-Satellite-Rocket-Competition-2024-2025/ESP32CAM-Payload-Case-v1-2.pdf

E E

F F

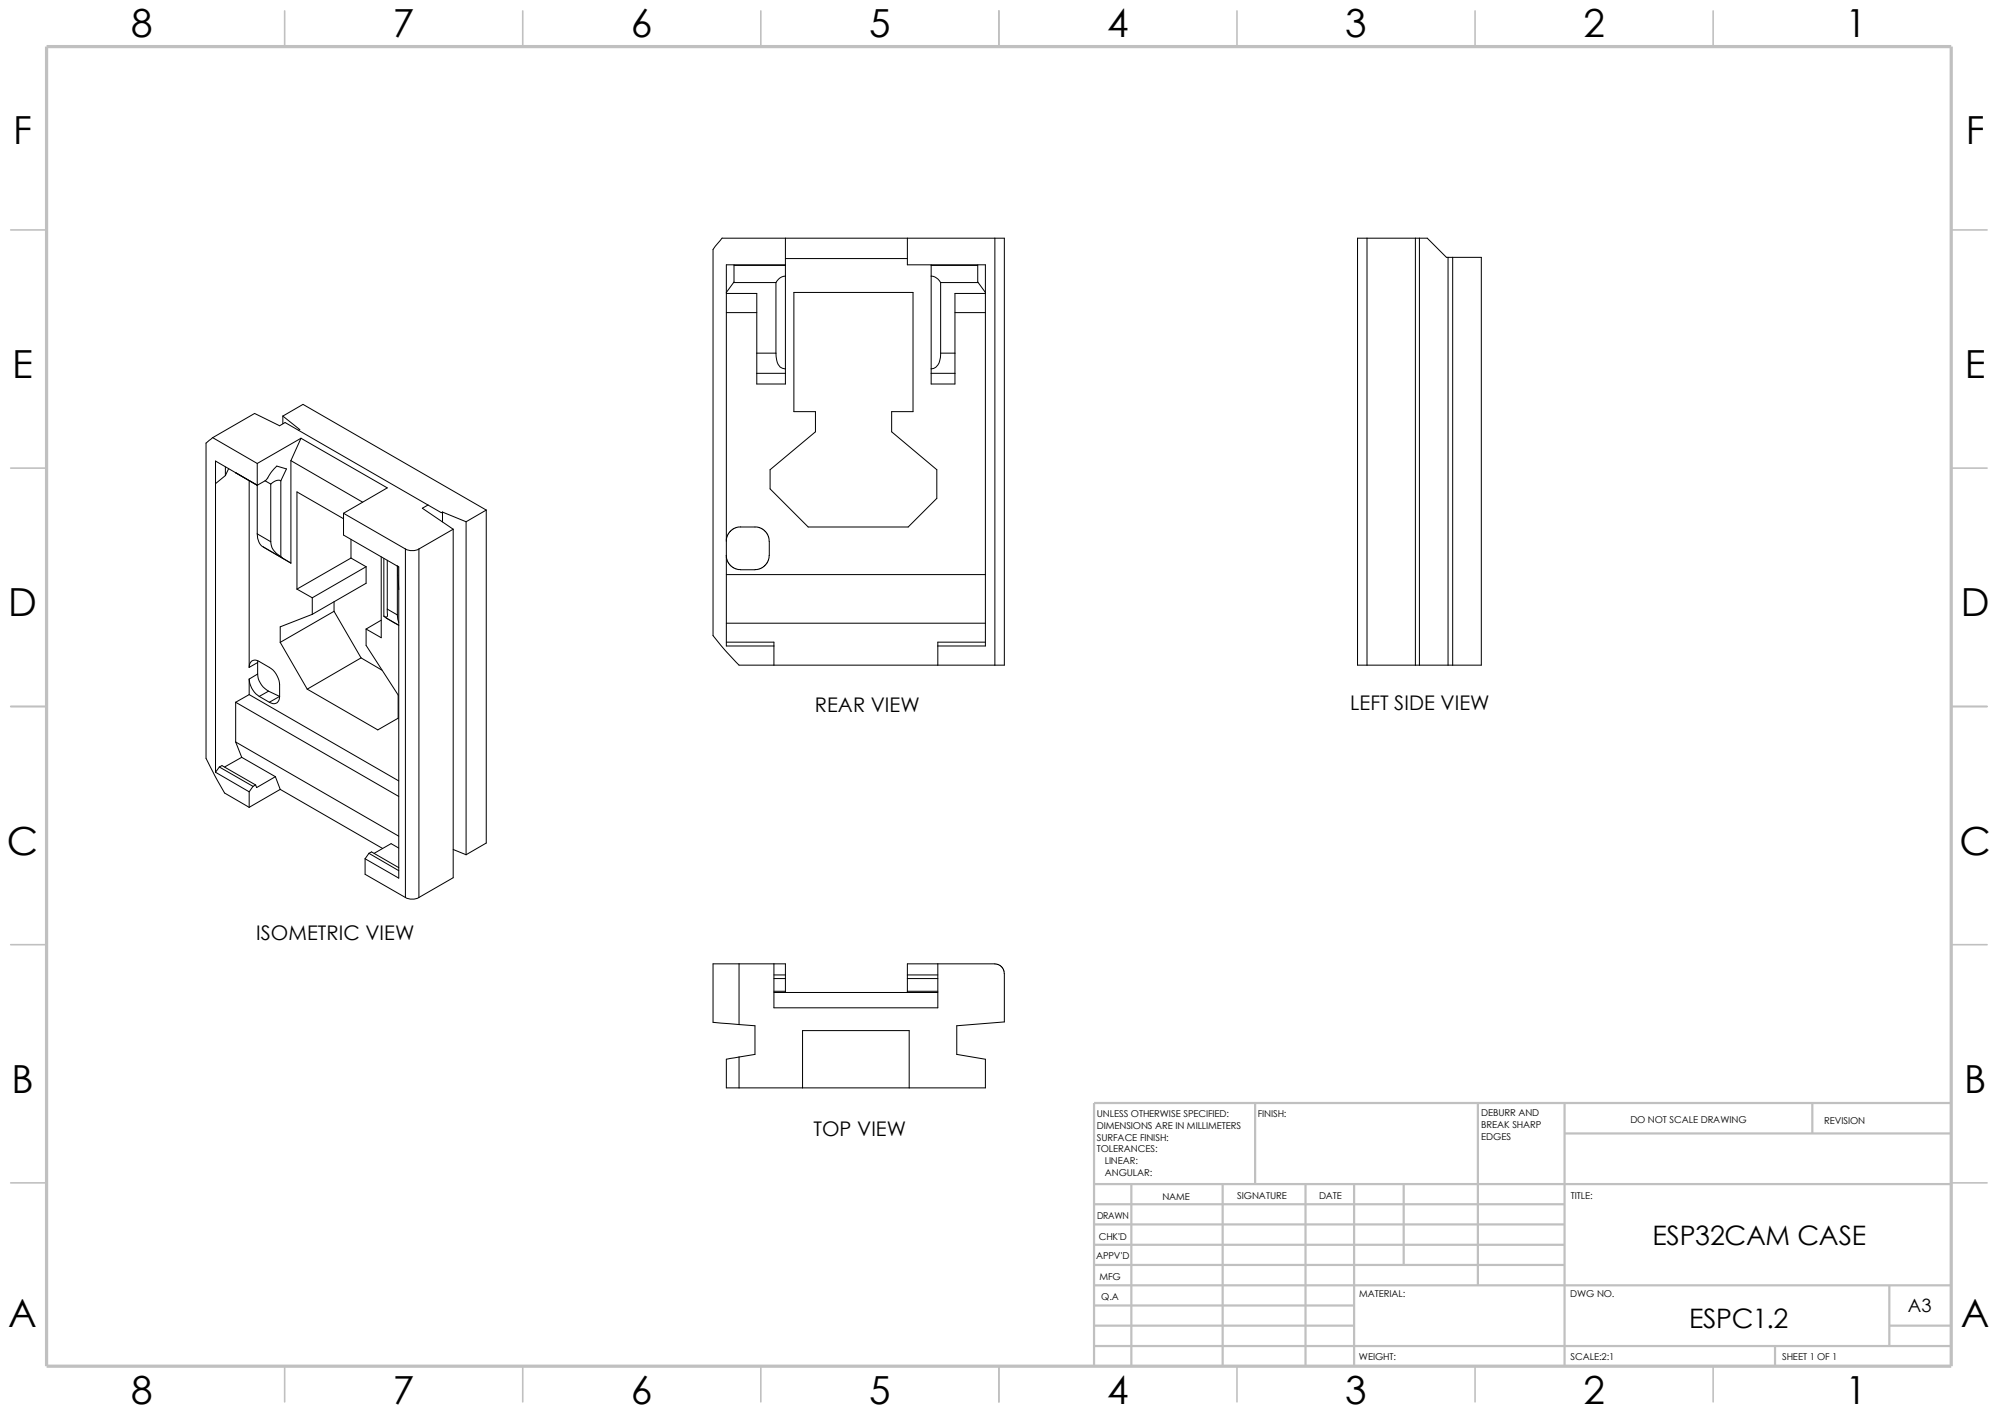
[picture p56: page 1]
SCALE:2:1; A A ESPC1.2; SHEET 1 OF 1; WEIGHT:; FINISH:; EDGES; DO NOT SCALE DRAWING; REVISION; DEBURR AND BREAK SHARP; ISOMETRIC VIEW; REAR VIEW; LEFT SIDE VIEW; TOP VIEW

UNLESS OTHERWISE SPECIFIED:
DIMENSIONS ARE IN MILLIMETERS
SURFACE FINISH:
TOLERANCES:
LINEAR:
ANGULAR:

NAME | SIGNATURE | DATE | | | | TITLE: ESP32CAM CASE

DRAWN
CHK'D
APPV'D
Q.A | | | | MATERIAL: | DWG NO. | A3

MFG
