PiStOn-DeEp/1st-Philippine-Can-Satellite-Rocket-Competition-2024-2025/Front-Frame-v1-2.pdf

E E

F F

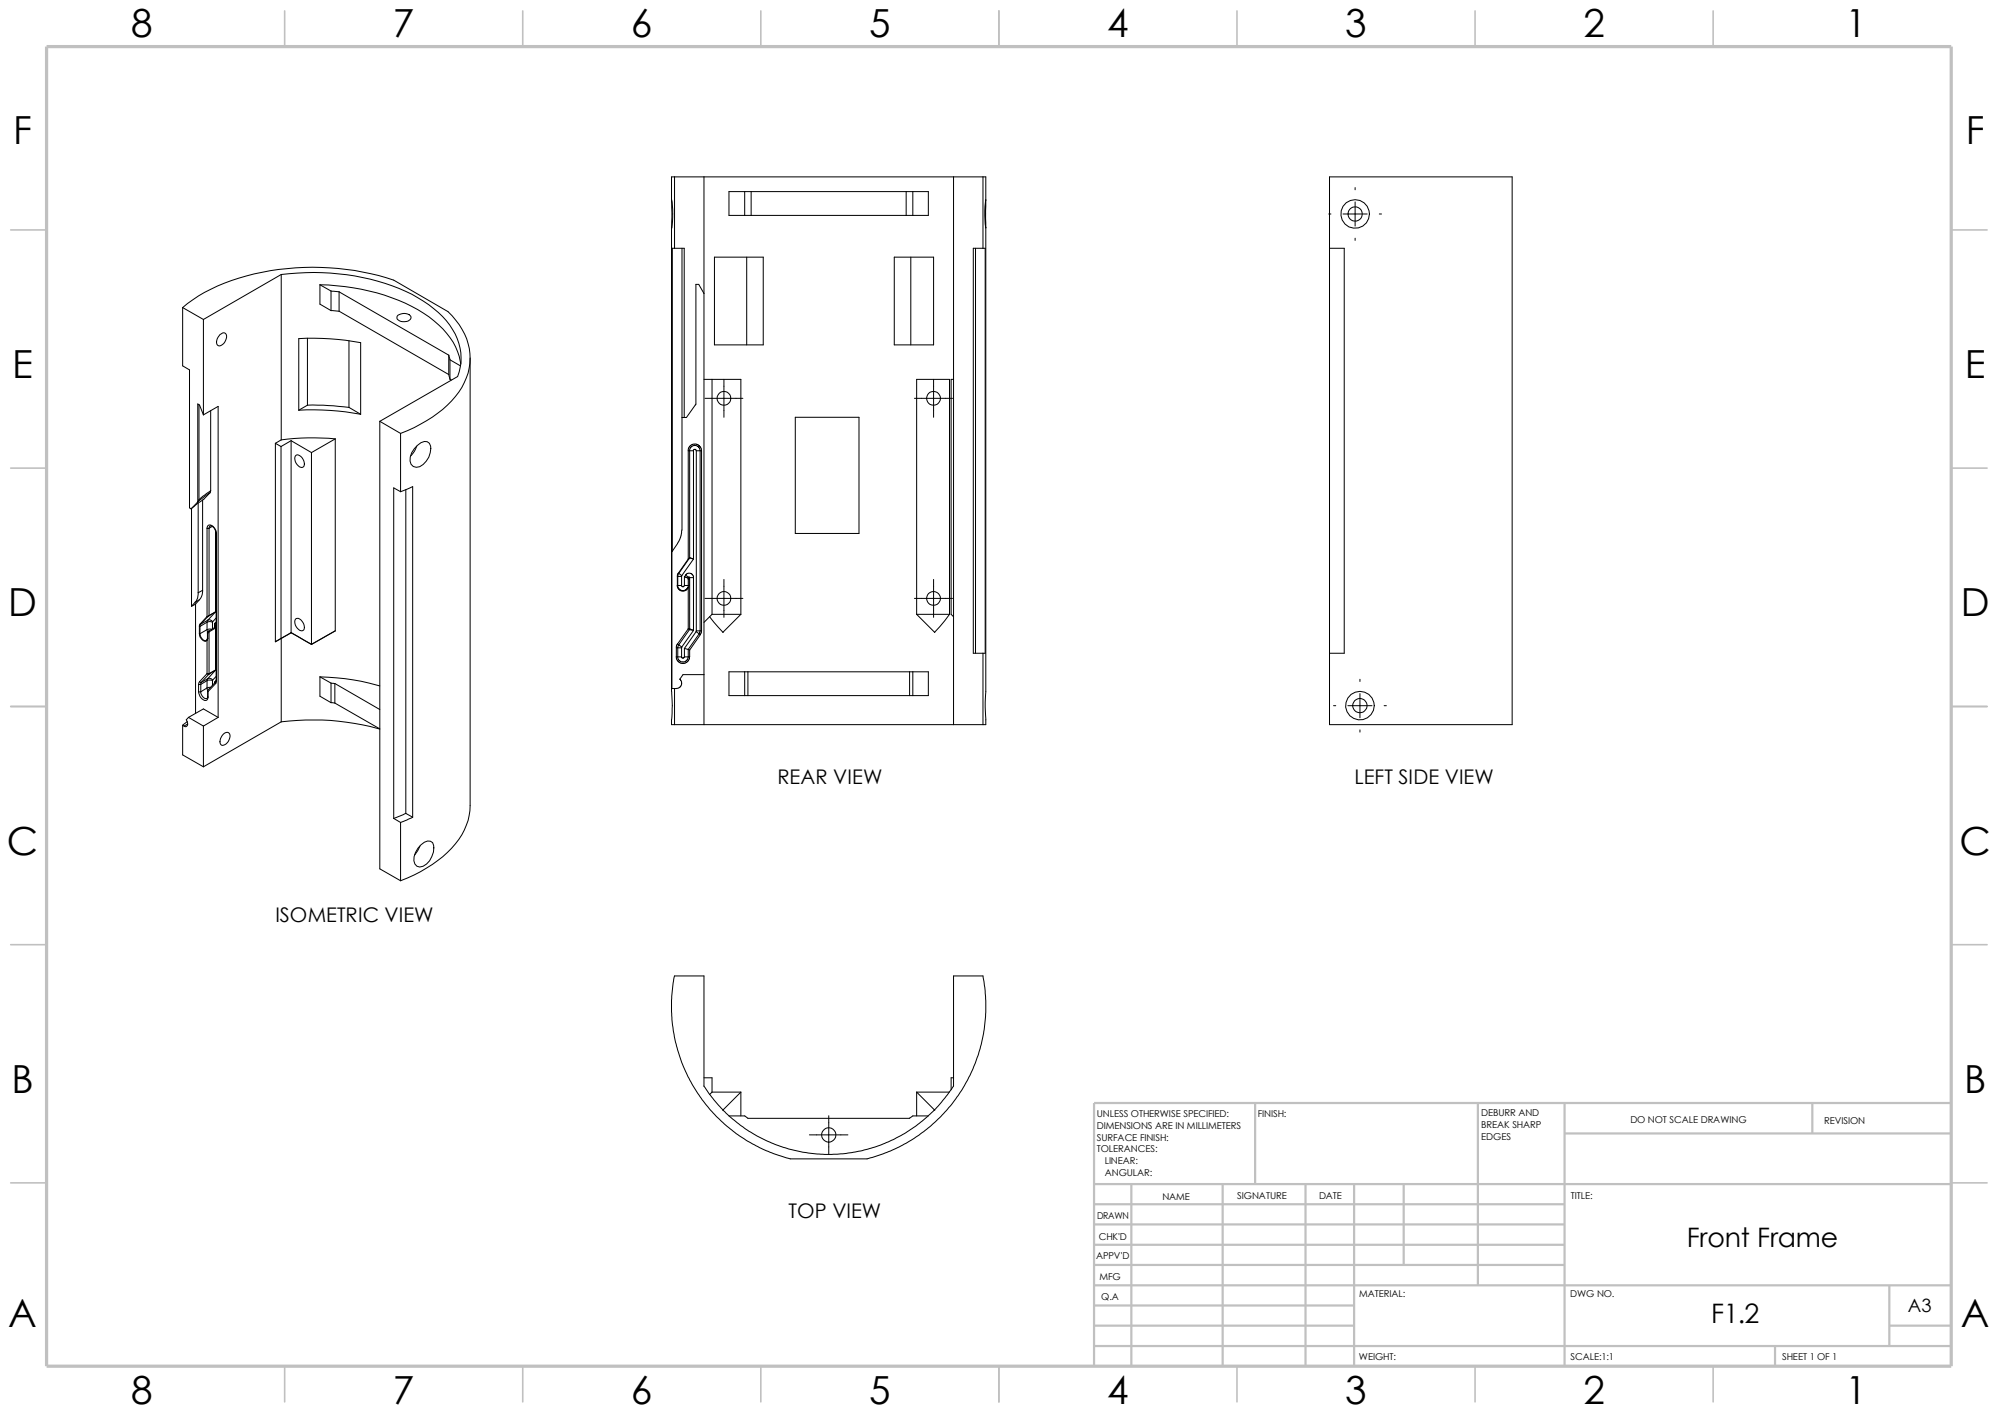
[picture p58: page 1]
SHEET 1 OF 1; WEIGHT:; SCALE:1:1; DO NOT SCALE DRAWING; REVISION; FINISH:; EDGES; DEBURR AND BREAK SHARP; REAR VIEW; ISOMETRIC VIEW; TOP VIEW

LEFT SIDE VIEW

UNLESS OTHERWISE SPECIFIED:
DIMENSIONS ARE IN MILLIMETERS
SURFACE FINISH:
TOLERANCES:
LINEAR:
ANGULAR:

NAME | SIGNATURE | DATE | | | | TITLE: Front Frame

DRAWN
CHK'D
APPV'D
Q.A | | | | MATERIAL: | DWG NO. | A3

MFG
