PiStOn-DeEp/1st-Philippine-Can-Satellite-Rocket-Competition-2024-2025/Mid-Frame-Payload-v2-1-1.pdf

E E

F F

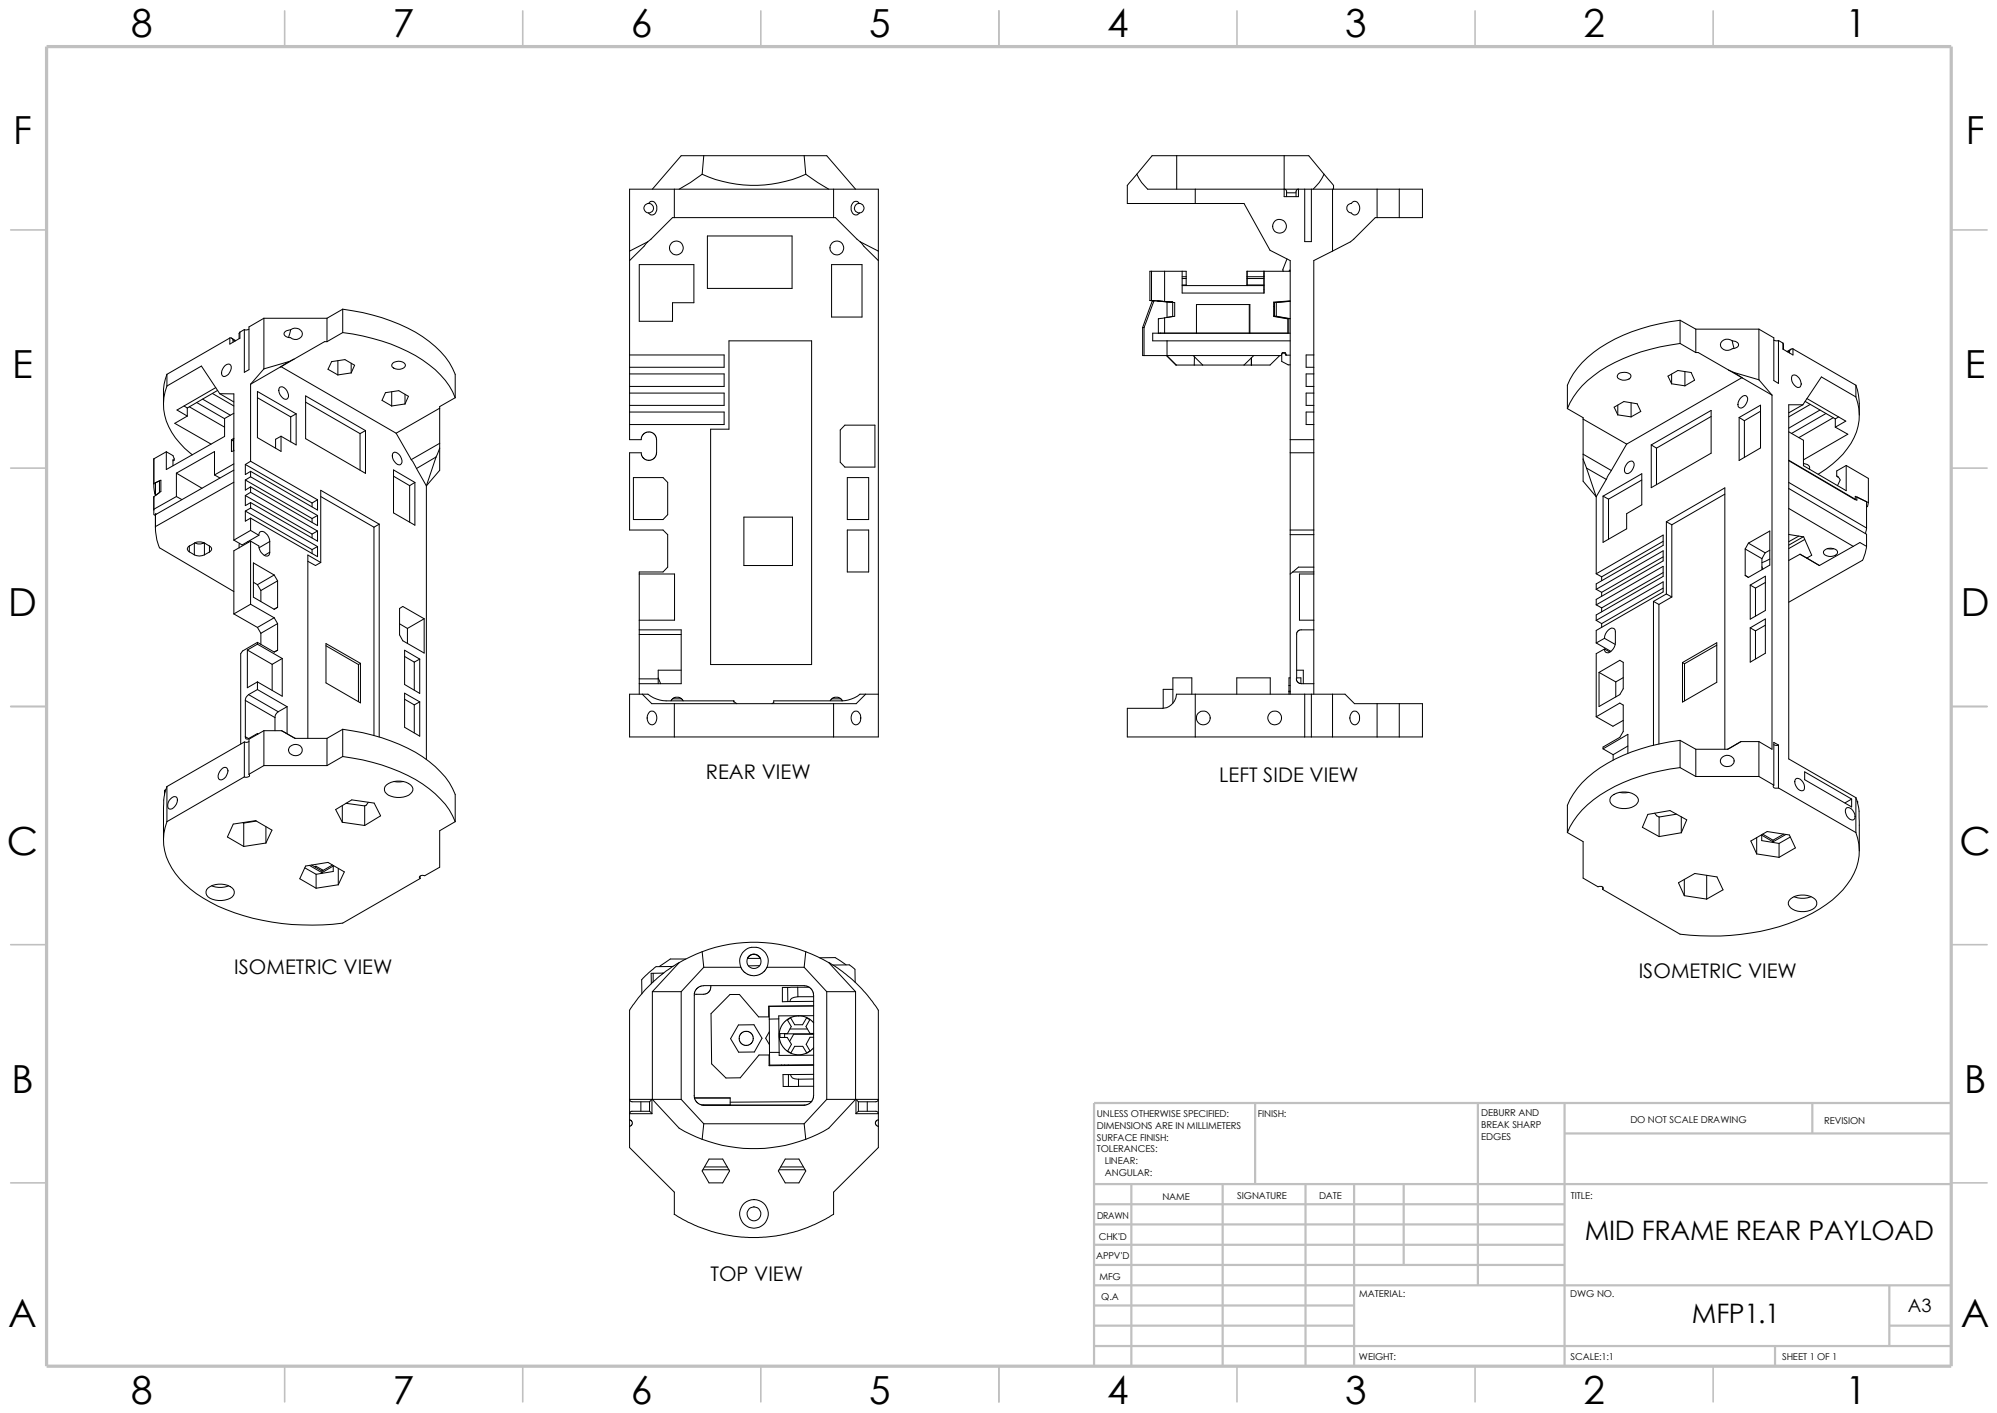
[picture p59: page 1]
WEIGHT:; A A MFP1.1; SCALE:1:1; SHEET 1 OF 1; REVISION; FINISH:; EDGES; DEBURR AND BREAK SHARP; REAR VIEW; ISOMETRIC VIEW; TOP VIEW

LEFT SIDE VIEW

DO NOT SCALE DRAWING UNLESS OTHERWISE SPECIFIED:
DIMENSIONS ARE IN MILLIMETERS
SURFACE FINISH:
TOLERANCES:
LINEAR:
ANGULAR:

NAME | SIGNATURE | DATE | | | | TITLE: MID FRAME REAR PAYLOAD

DRAWN
CHK'D
APPV'D
Q.A | | | | MATERIAL: | DWG NO. | A3

MFG
