PiStOn-DeEp/1st-Philippine-Can-Satellite-Rocket-Competition-2024-2025/Mid-Frame-Payload-v2-1-2.pdf

E E

F F

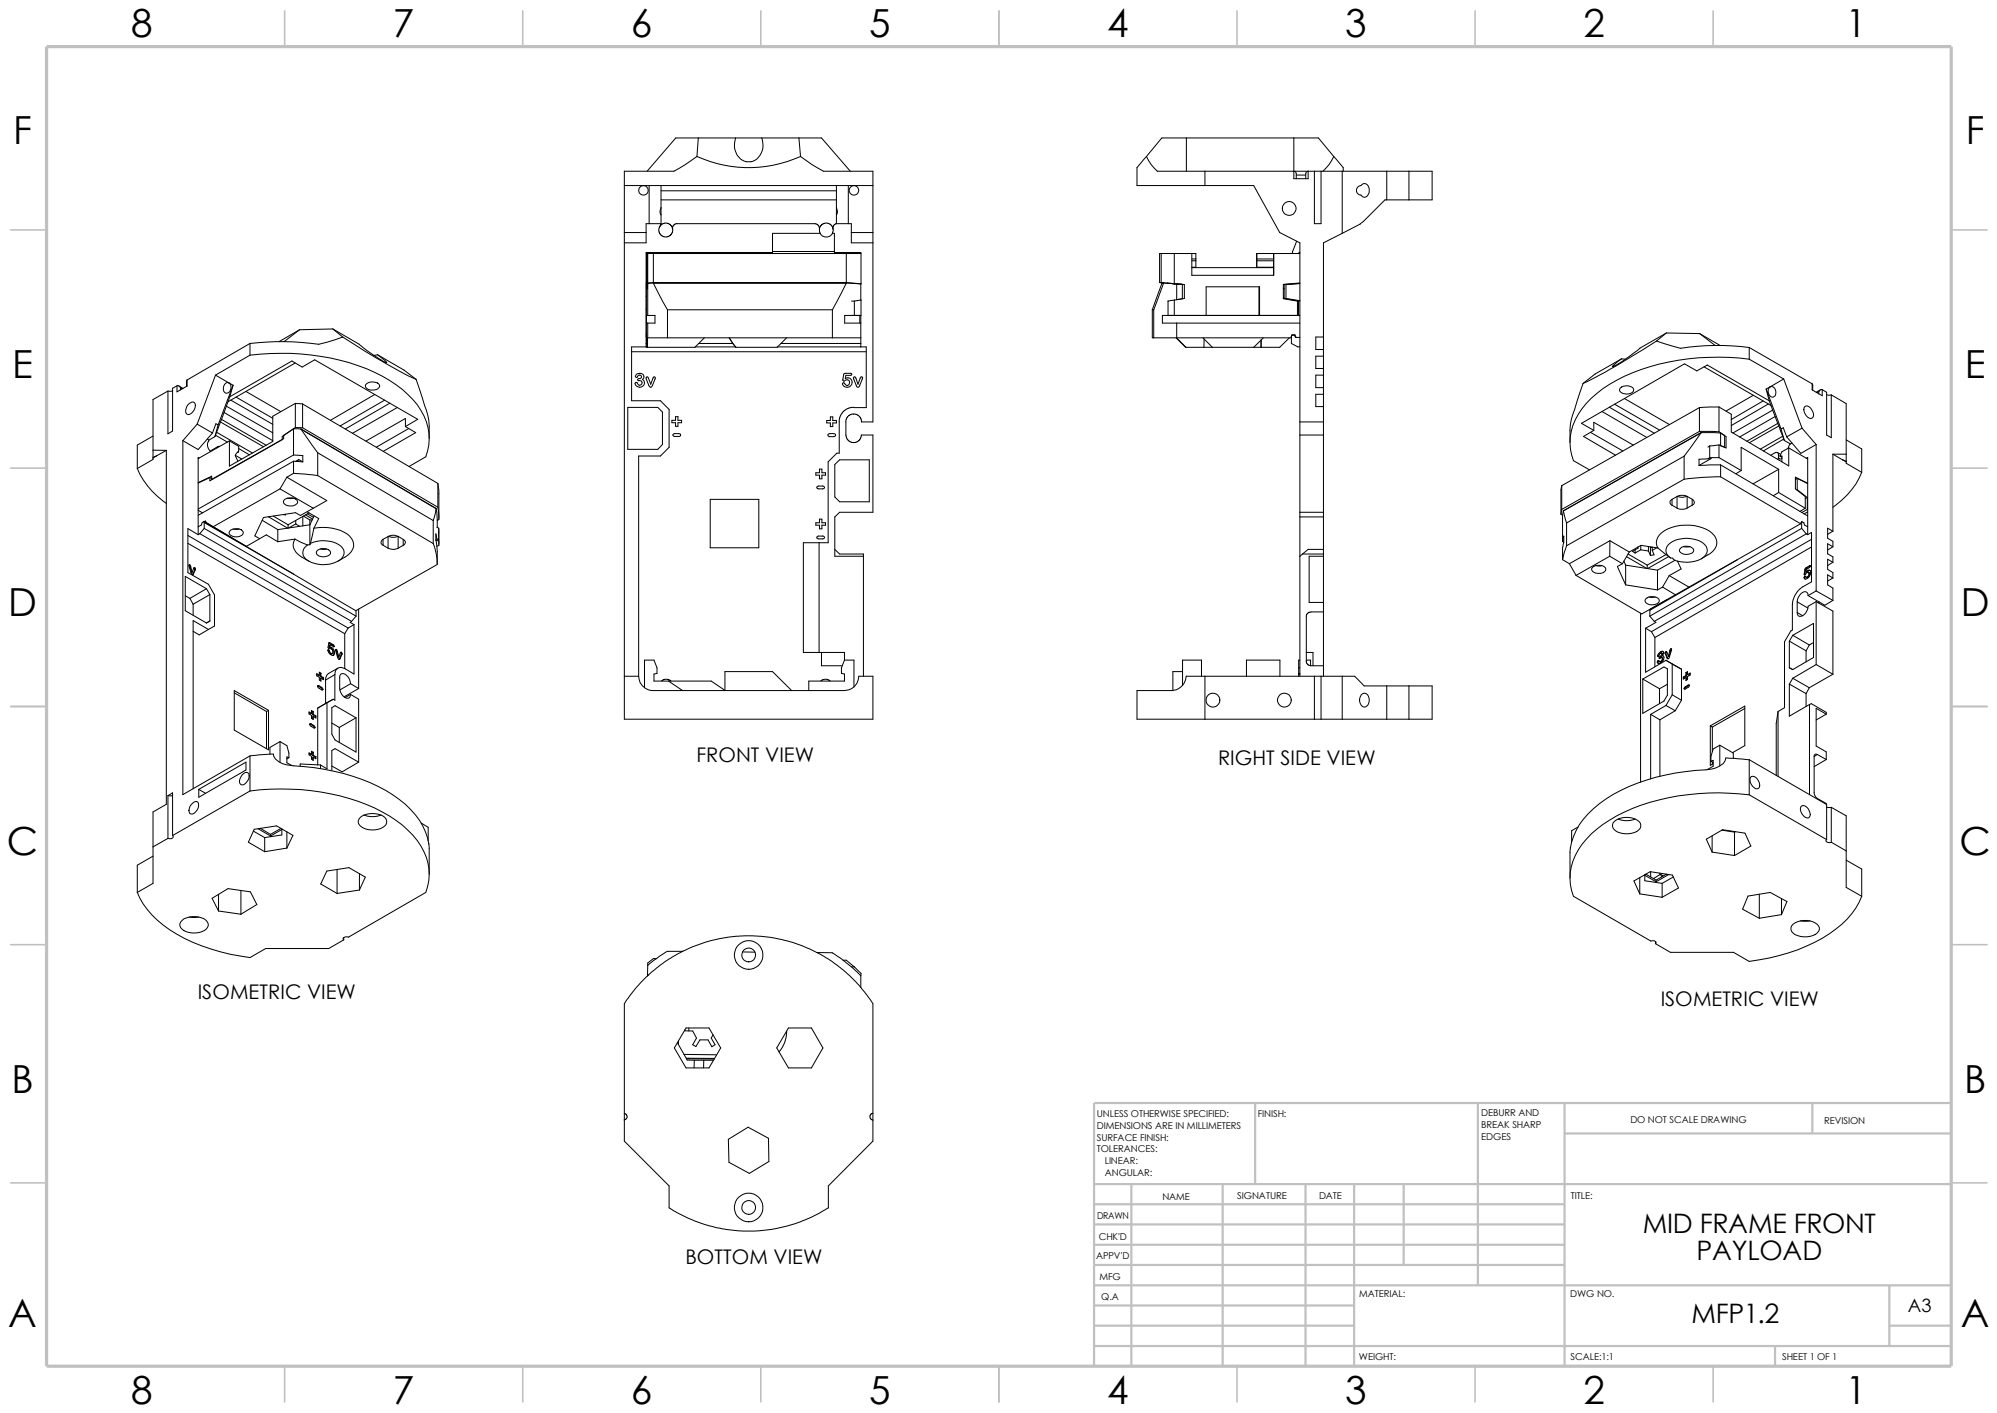
[picture p60: page 1]
BREAK SHARP; REVISION; FINISH:; EDGES; DEBURR AND; ISOMETRIC VIEW; BOTTOM VIEW; FRONT VIEW; RIGHT SIDE VIEW

DO NOT SCALE DRAWING UNLESS OTHERWISE SPECIFIED:
DIMENSIONS ARE IN MILLIMETERS
SURFACE FINISH:
TOLERANCES:
LINEAR:
ANGULAR:

NAME | SIGNATURE | DATE | | | | TITLE: MID FRAME FRONT PAYLOAD

DRAWN
CHK'D
APPV'D
MATERIAL: | DWG NO. MFP1.2 | A3 Q.A

MFG

WEIGHT: | SCALE:1:1 | SHEET 1 OF 1
