PiStOn-DeEp/1st-Philippine-Can-Satellite-Rocket-Competition-2024-2025/Middle-Frame-v1-1.pdf

E E

F F

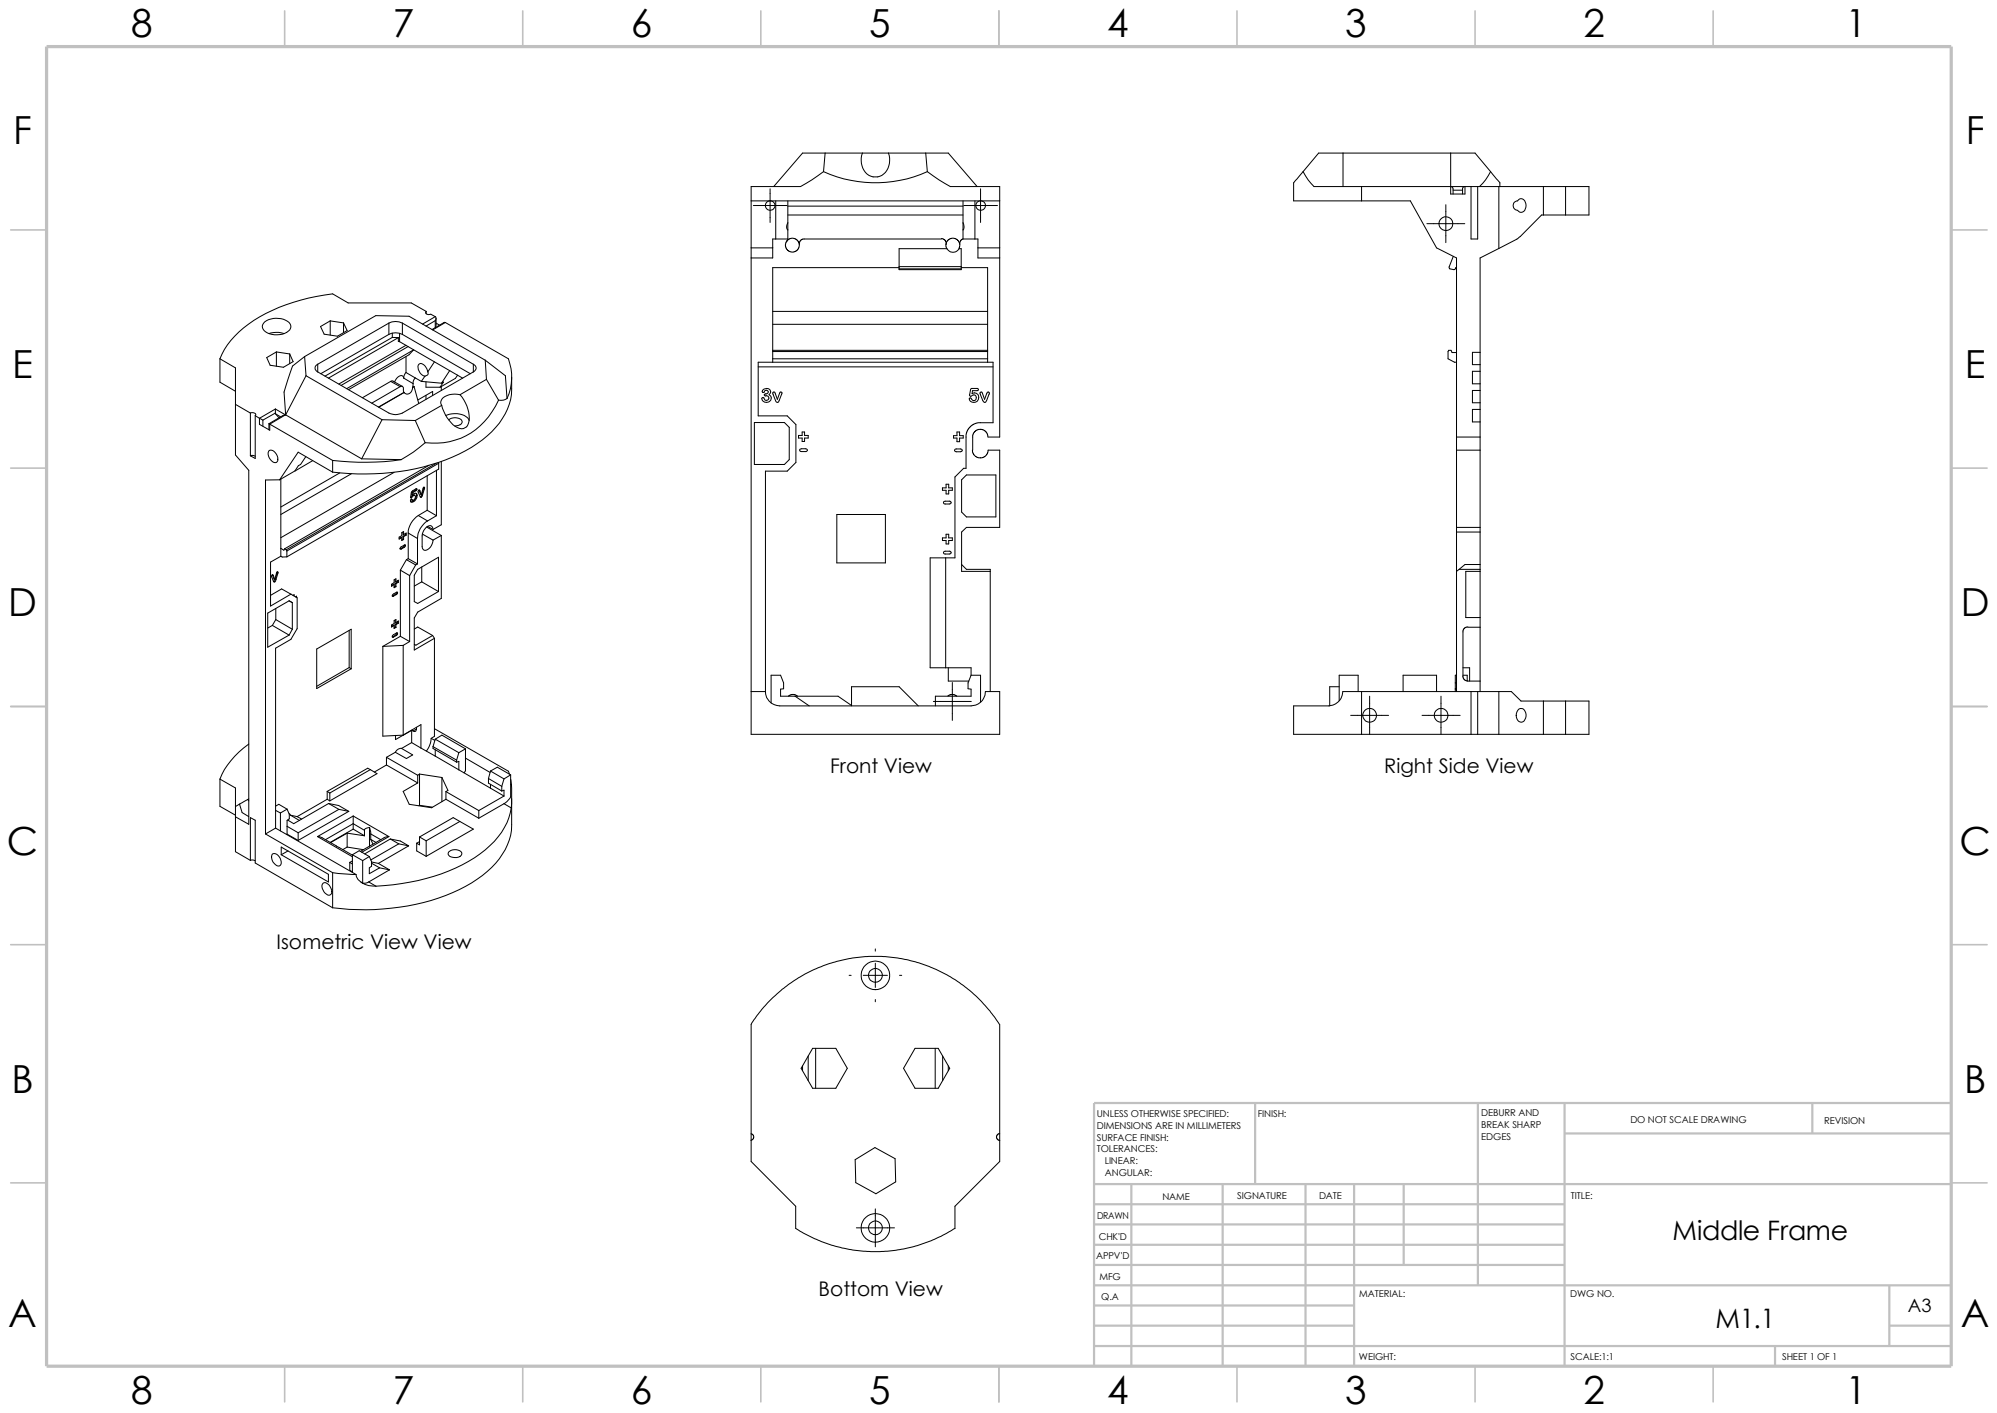
[picture p61: page 1]
REVISION; SHEET 1 OF 1; SCALE:1:1; WEIGHT:; EDGES; UNLESS OTHERWISE SPECIFIED:; FINISH:; DEBURR AND BREAK SHARP; Front View; Right Side View; Bottom View

Isometric View View

DIMENSIONS ARE IN MILLIMETERS
SURFACE FINISH:
TOLERANCES:
LINEAR:
ANGULAR:

DO NOT SCALE DRAWING

NAME | SIGNATURE | DATE | | | | TITLE: Middle Frame

DRAWN
CHK'D
APPV'D

MFG
Q.A | | | | MATERIAL: | DWG NO. M1.1 | A3
