PiStOn-DeEp/1st-Philippine-Can-Satellite-Rocket-Competition-2024-2025/Middle-Frame-v1-2.pdf

E E

F F

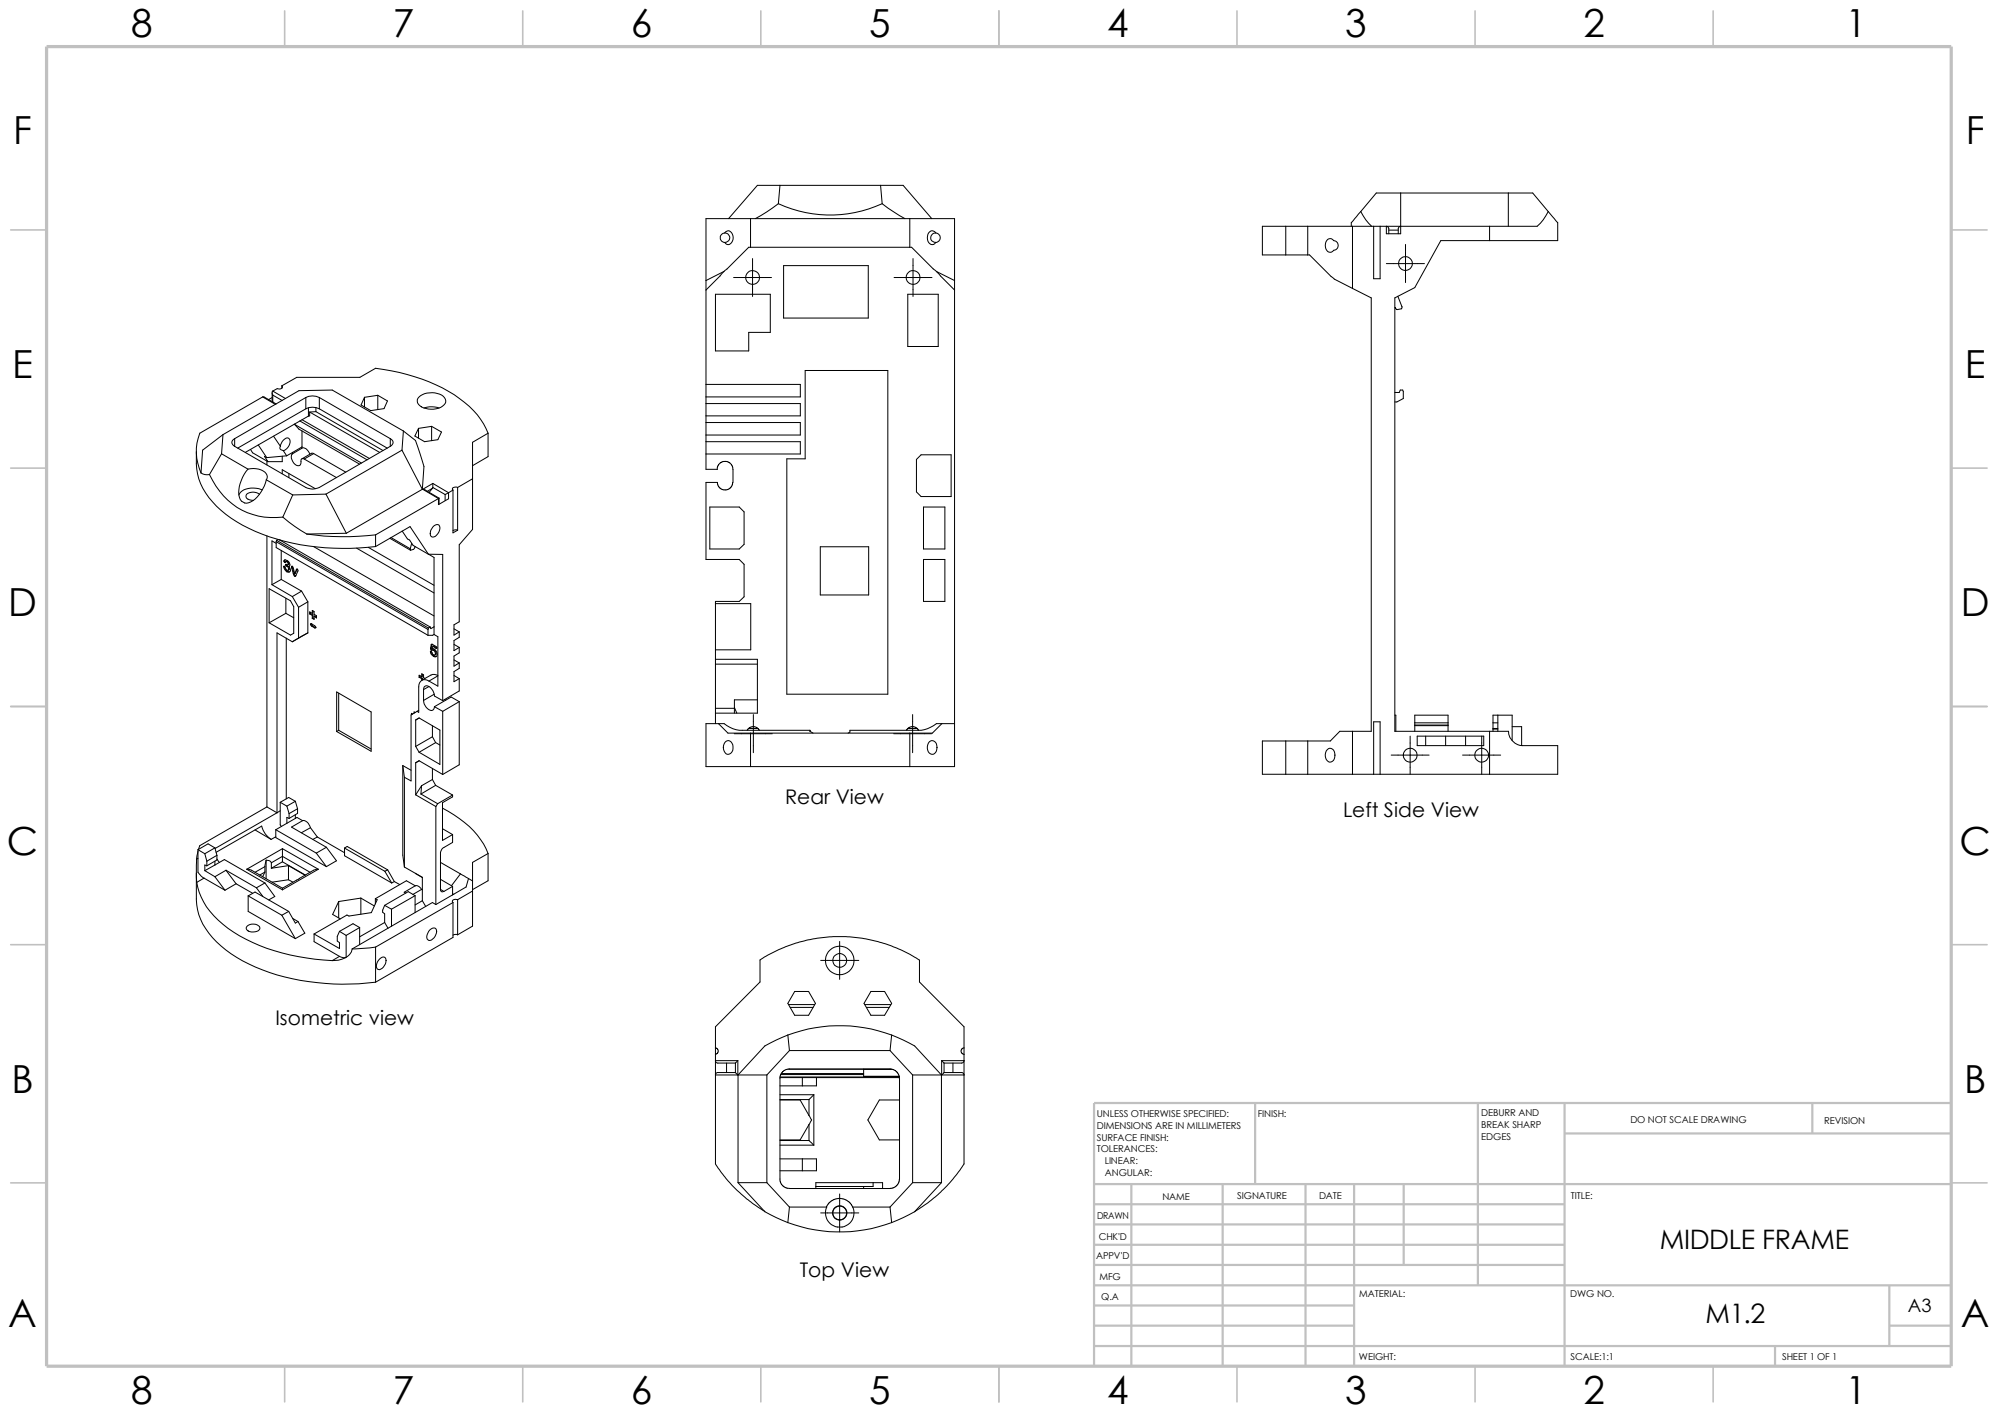
[picture p62: page 1]
WEIGHT:; SHEET 1 OF 1; SCALE:1:1; REVISION; FINISH:; EDGES; DEBURR AND BREAK SHARP; Top View; Isometric view

Left Side View Rear View

DO NOT SCALE DRAWING UNLESS OTHERWISE SPECIFIED:
DIMENSIONS ARE IN MILLIMETERS
SURFACE FINISH:
TOLERANCES:
LINEAR:
ANGULAR:

NAME | SIGNATURE | DATE | | | | TITLE: MIDDLE FRAME

DRAWN
CHK'D
APPV'D
Q.A | | | | MATERIAL: | DWG NO. | A3

MFG
