PiStOn-DeEp/1st-Philippine-Can-Satellite-Rocket-Competition-2024-2025/Middle-Frame-v1.pdf

E E

F F

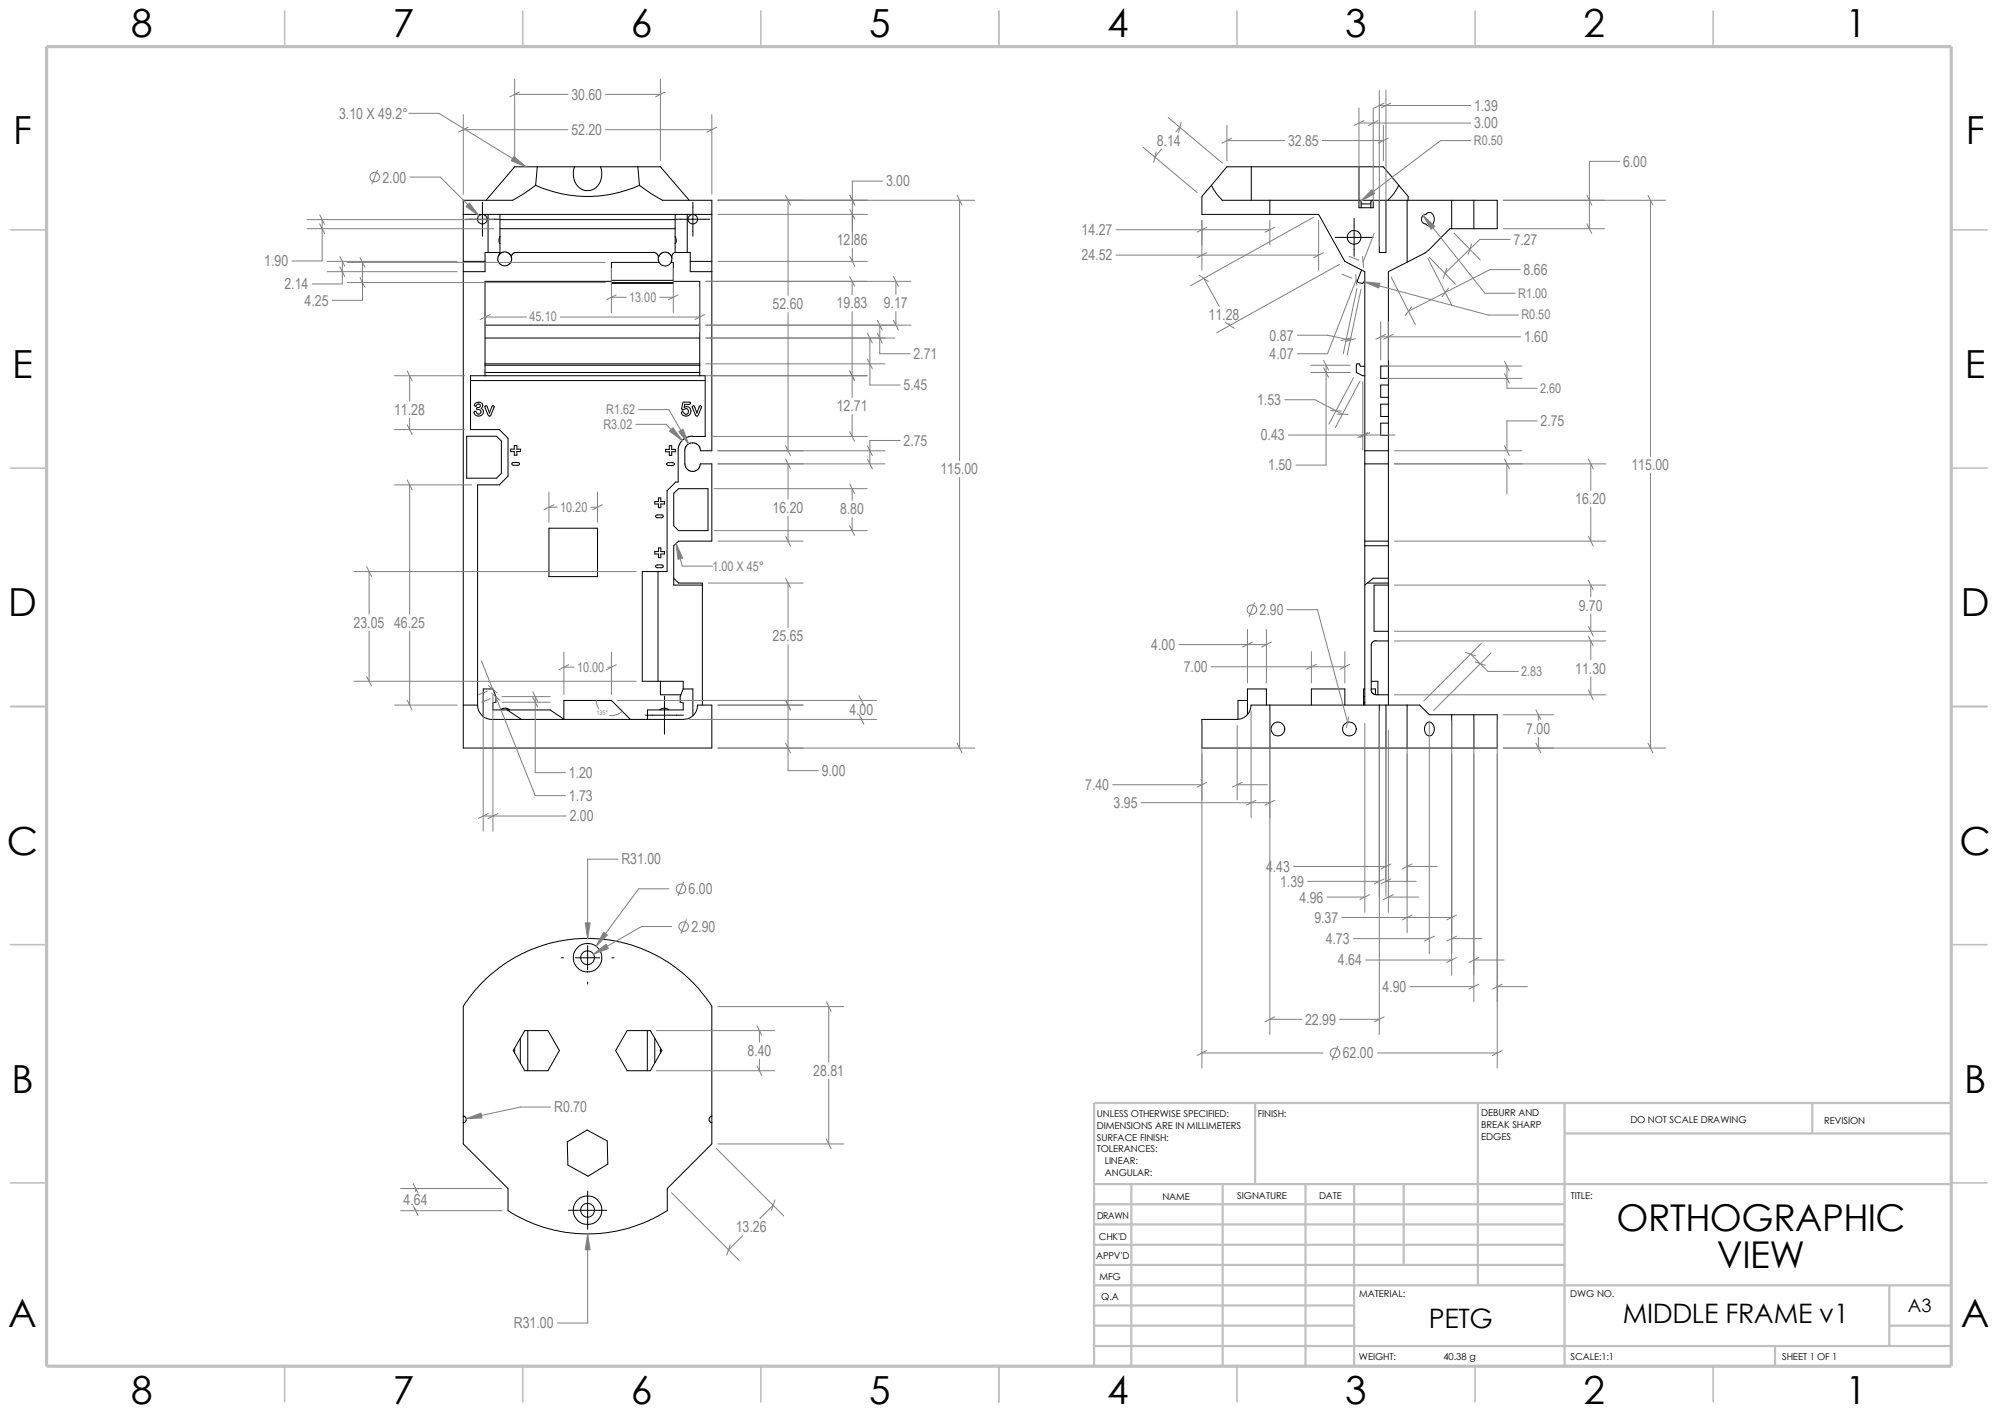
[picture p63: page 1]
SIGNATURE; WEIGHT:; BREAK SHARP; VIEW; A A PETG; SCALE:1:1; DO NOT SCALE DRAWING; REVISION; DATE; TITLE: DRAWN; FINISH:; EDGES; SHEET 1 OF 1; NAME; DEBURR AND; ORTHOGRAPHIC

UNLESS OTHERWISE SPECIFIED:
DIMENSIONS ARE IN MILLIMETERS
SURFACE FINISH:
TOLERANCES:
LINEAR:
ANGULAR:

CHK'D
APPV'D
Q.A | MATERIAL: | DWG NO. MIDDLE FRAME v1 | A3

MFG
