PiStOn-DeEp/1st-Philippine-Can-Satellite-Rocket-Competition-2024-2025/Power-Cover-v1-1-2.pdf

E E

F F

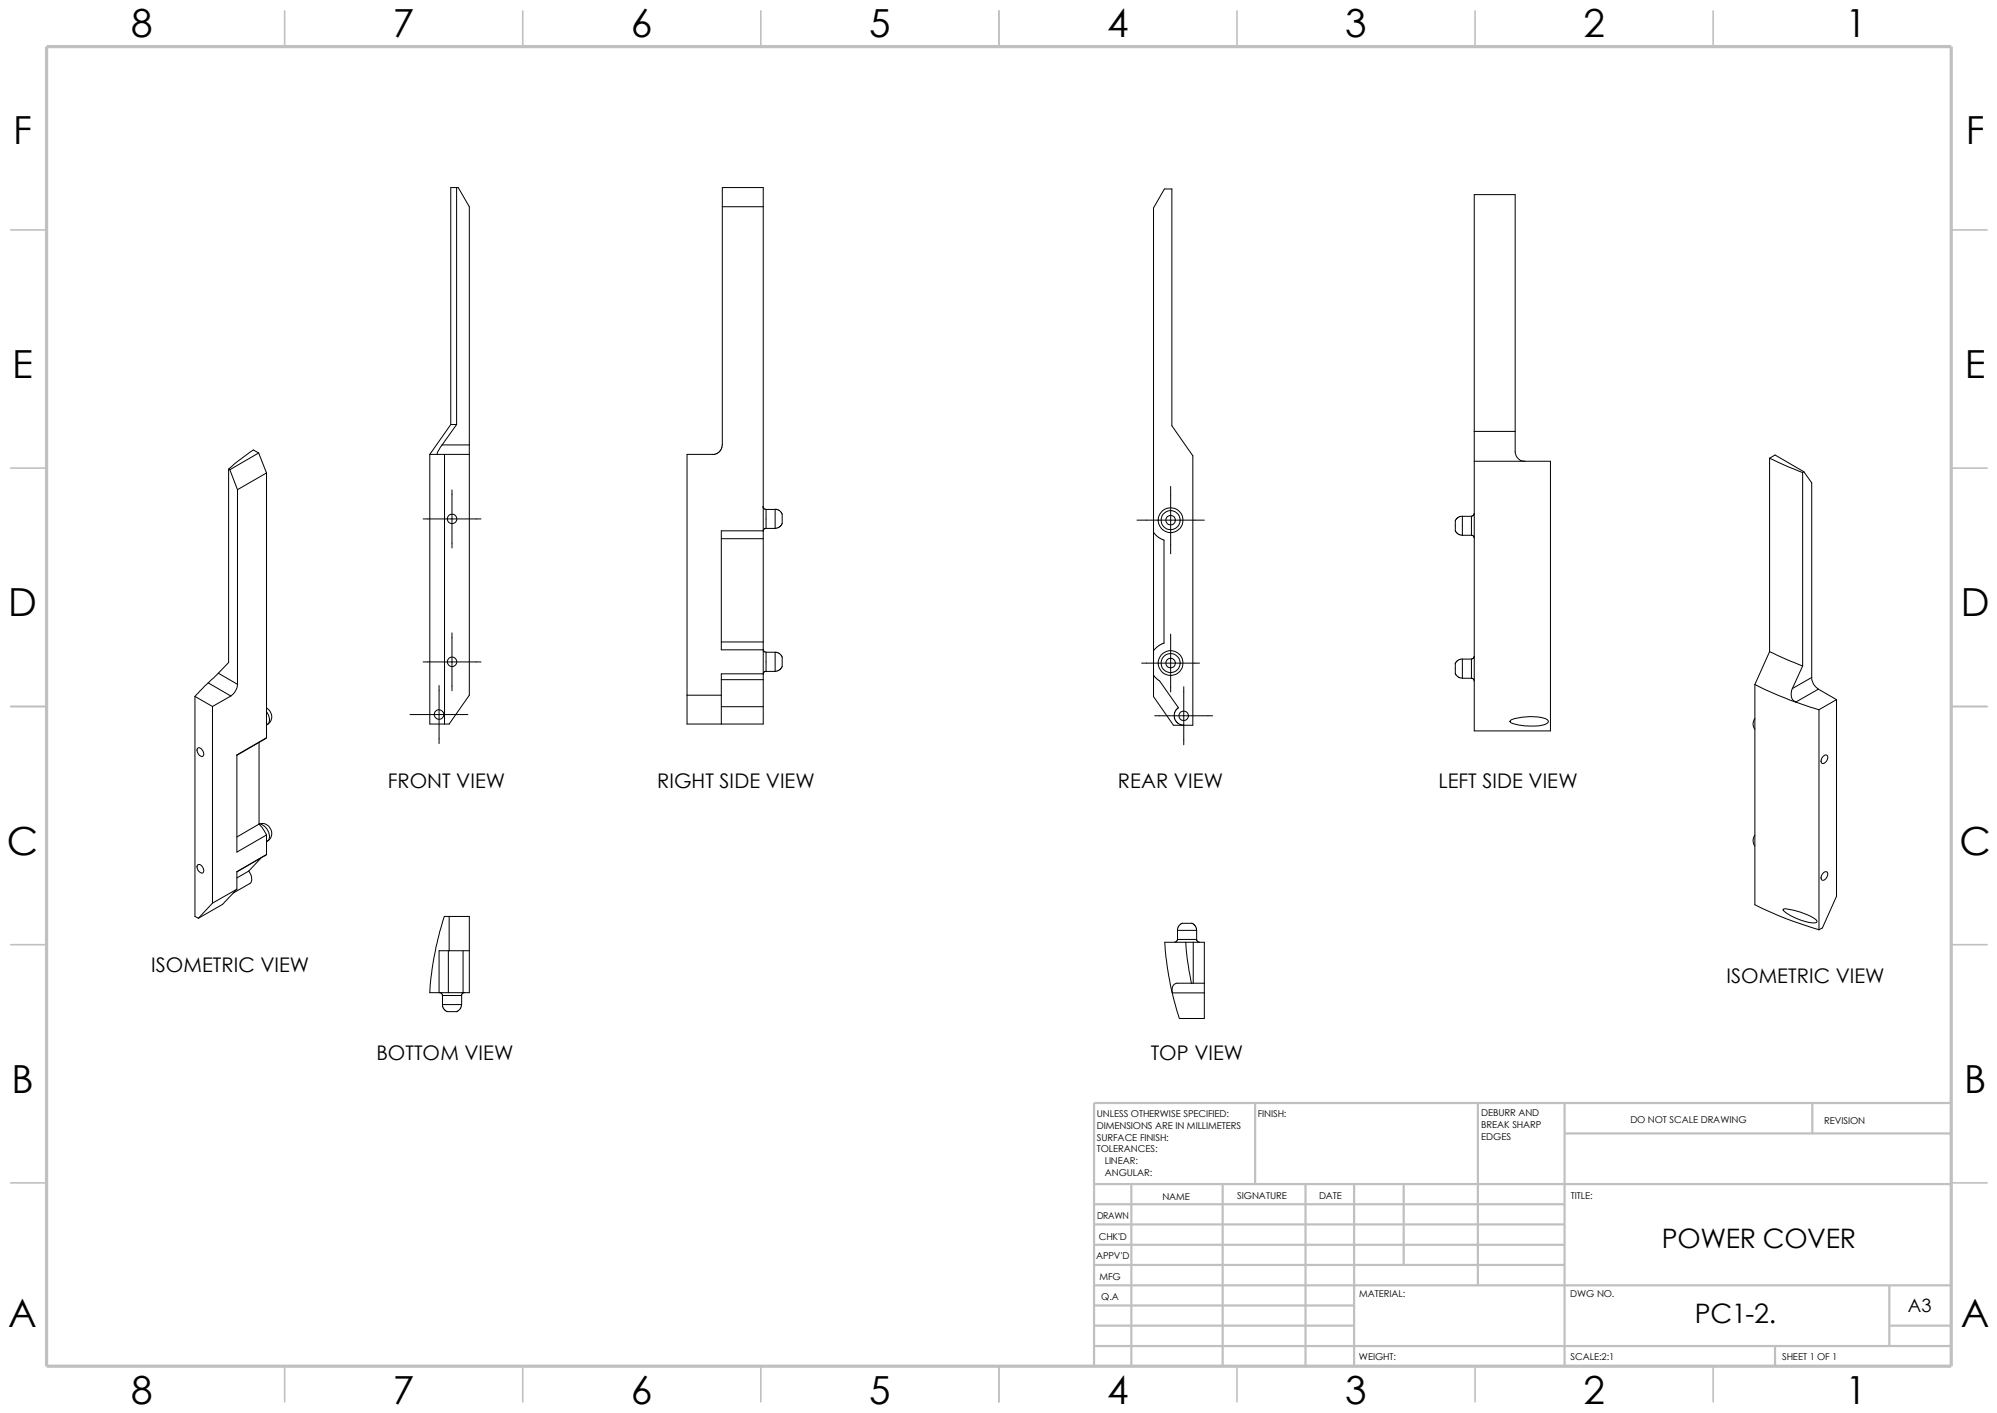
[picture p64: page 1]
SCALE:2:1; WEIGHT:; SHEET 1 OF 1; FINISH:; EDGES; DO NOT SCALE DRAWING; REVISION; DEBURR AND BREAK SHARP; BOTTOM VIEW; TOP VIEW; FRONT VIEW; RIGHT SIDE VIEW; REAR VIEW; LEFT SIDE VIEW; ISOMETRIC VIEW

UNLESS OTHERWISE SPECIFIED:
DIMENSIONS ARE IN MILLIMETERS
SURFACE FINISH:
TOLERANCES:
LINEAR:
ANGULAR:

NAME | SIGNATURE | DATE | | | | TITLE: POWER COVER

DRAWN
CHK'D
APPV'D
Q.A | | | | MATERIAL: | DWG NO. | A3

MFG
